SunDevilRocketry/Flight-Computer/README.md

<h1>Flight Computer</h1>

<p><b>Current PCB Revision:</b> 2.0</p>
<p><b>PCB Part Number:</b> A0002</p>

<p>The Avionics team aims to produce a general purpose flight computer 
 for use in high powered rocketry projects that require an embedded processor
specialized for state estimation and control system implementation. The Avionics
flight computer PCB uses an ARM Microcontroller with embedded control and 
navigation sensors to provide a computationally capable embedded protoyping 
platform for high powered rocketry projects with minimal wiring and a small
 form factor.</p>

<b>Working Directory Structure:</b>
 
 <p>
doc: documentation
    
src: source design files, e.g. schematic and board files
 
lib: libraries for schematic symbols and footprints
 
production: files needed for pcb fabrication, e.g. gerbers, profile, drill fi    le
 
 sim: simulation files 
  
 cad: 3d models
   
 img: images of circuit/footprints for github display 
 </p>

<h2>3D Model: </h2>

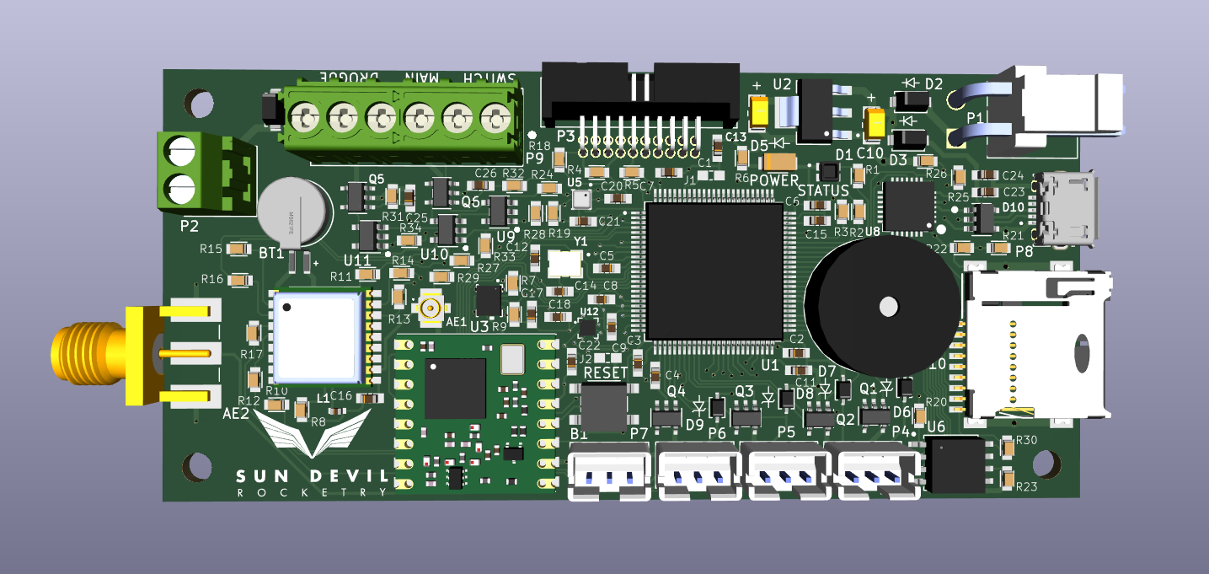
[picture p1: img/Flight-Computer-TOP.png]

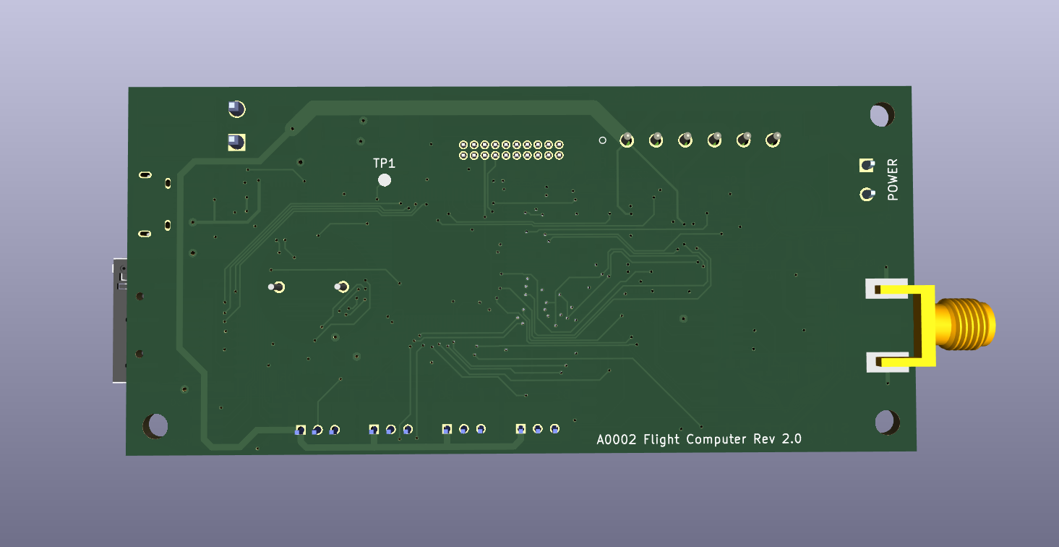
[picture p2: img/Flight-Computer-BOTTOM.png]
