SunDevilRocketry/Flight-Computer/CAD/README.md

<h1>CAD</h1>

Folder for all PCB 3D Models (STEP)

Use the folder "3Dfiles" for individual components' STEP files
