SunDevilRocketry/Flight-Computer/doc/README.md

<h1>Documentation</h1>

Folder for all PCB documentation
