SunDevilRocketry/Flight-Computer/img/README.md

<h1>Images</h1>

Folder for all PCB images to be displayed on GitHub

To show a picture, use the following html syntax: 
