SunDevilRocketry/Flight-Computer/src/README.md

<h1>Source Design Files</h1>

Folder for all PCB design files, including project, schematic, and PCB layout 
files
