SunDevilRocketry/Flight-Computer/CAD/3Dfiles/README.md

Folder for all PCB component step files

Download the files from online and keep them all here
