SunDevilRocketry/Flight-Computer/CAD/3Dfiles/BMI323.step

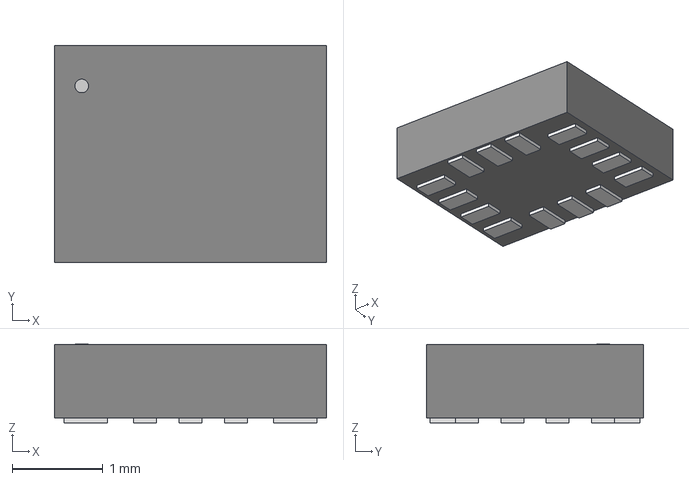
[picture p3: CAD file, 2022-12-14]
CAD/3Dfiles/BMI323.step
3.00 x 2.39 x 0.866 mm
