SunDevilRocketry/Flight-Computer/CAD/3Dfiles/BMM150.step

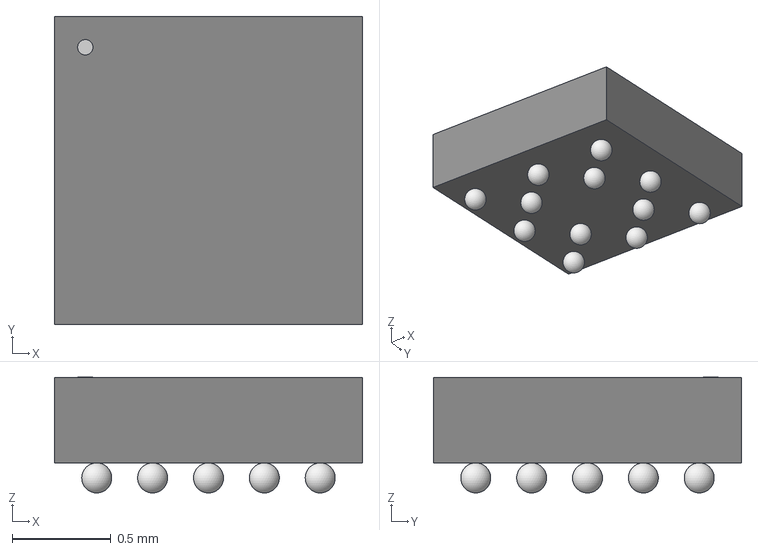
[picture p4: CAD file, 2022-12-14]
CAD/3Dfiles/BMM150.step
1.56 x 1.56 x 0.587 mm
