SunDevilRocketry/Flight-Computer/CAD/3Dfiles/AT-1438-TWT-R.STEP

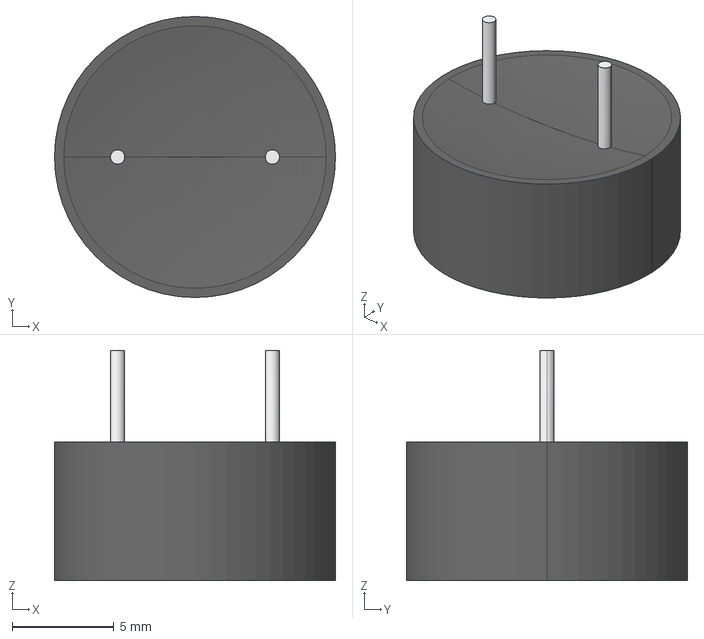
[picture p5: CAD file, 2022-06-05]
CAD/3Dfiles/AT-1438-TWT-R.STEP
13.8 x 13.8 x 11.3 mm
