SunDevilRocketry/Flight-Computer/CAD/3Dfiles/MEM2075-00-140-01-A.stp

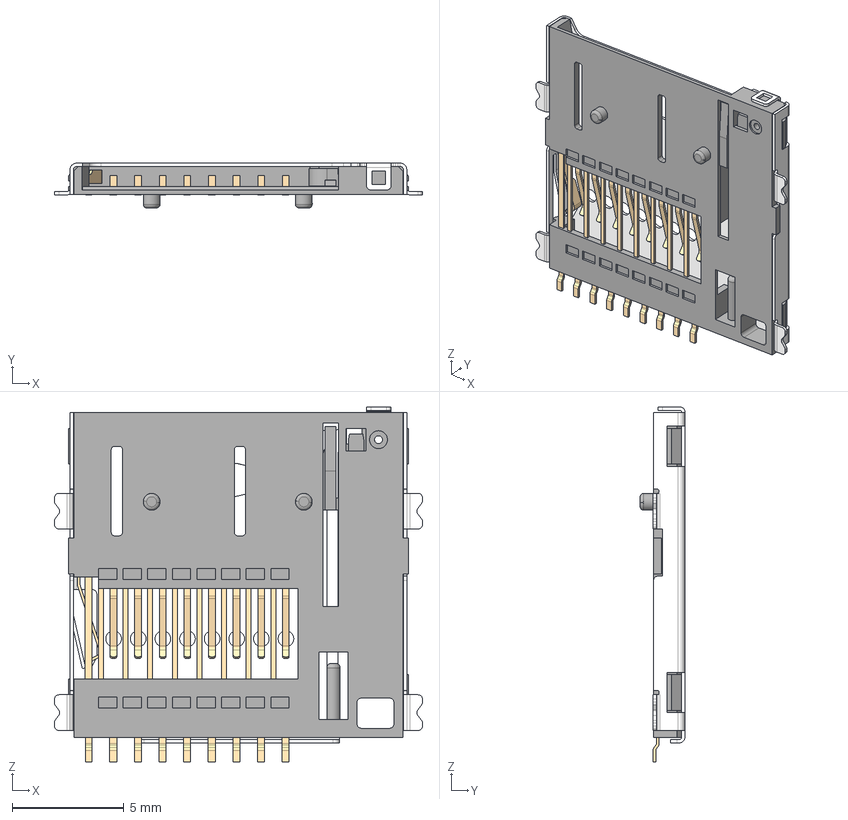
[picture p6: CAD file, 2022-06-04]
CAD/3Dfiles/MEM2075-00-140-01-A.stp
16.4 x 2.00 x 15.9 mm
Ëõ·Å±ÈÀý1
Í¹Ì¨-ÀÉì1
Á¬½ÓÖØ×é1
