SunDevilRocketry/Flight-Computer/CAD/3Dfiles/L-07C27NJV6T.step

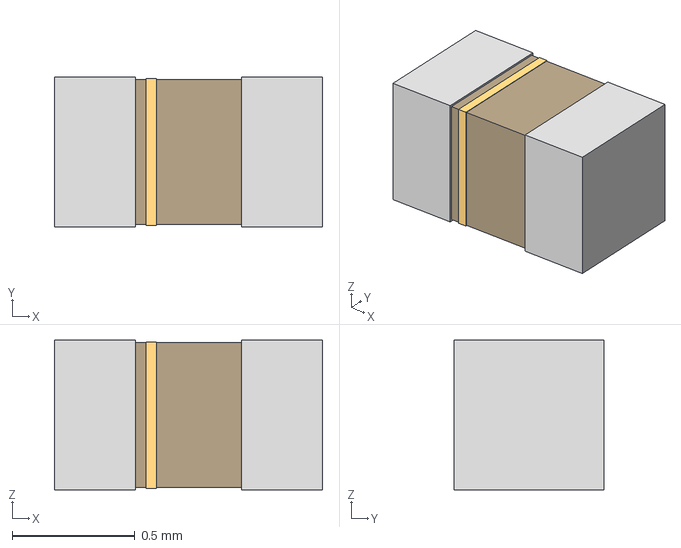
[picture p7: CAD file, 2022-06-01]
CAD/3Dfiles/L-07C27NJV6T.step
1.09 x 0.61 x 0.61 mm
