SunDevilRocketry/Flight-Computer/CAD/3Dfiles/MM3Z3V3B.step

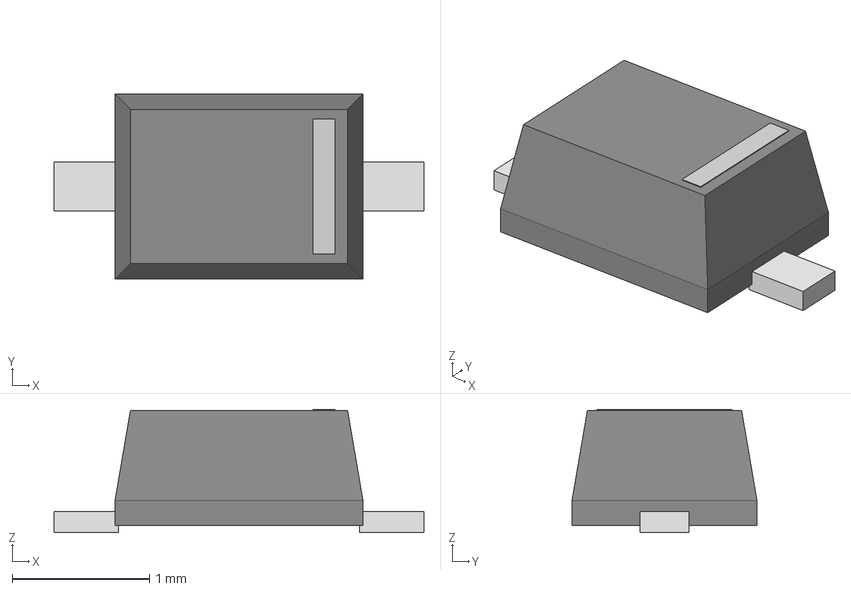
[picture p8: CAD file, 2022-06-01]
CAD/3Dfiles/MM3Z3V3B.step
2.69 x 1.35 x 0.895 mm
