SunDevilRocketry/Flight-Computer/CAD/3Dfiles/MS621FE-1.STEP

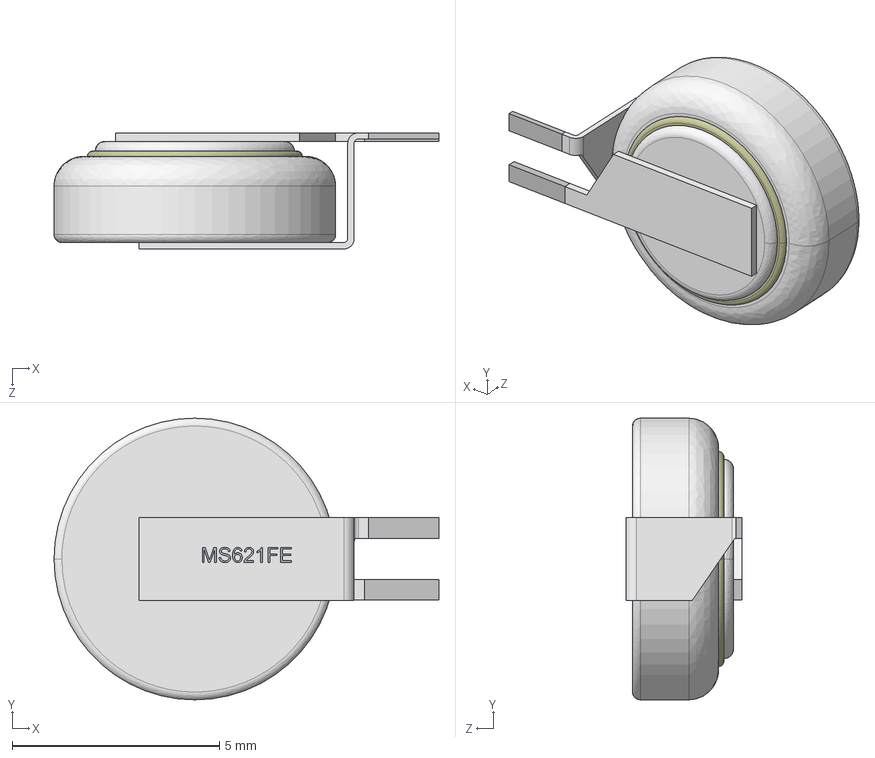
[picture p10: CAD file, 2022-05-29]
CAD/3Dfiles/MS621FE-1.STEP
9.29 x 6.80 x 2.80 mm
