SunDevilRocketry/Flight-Computer/CAD/3Dfiles/MAX-8C-0-10.step

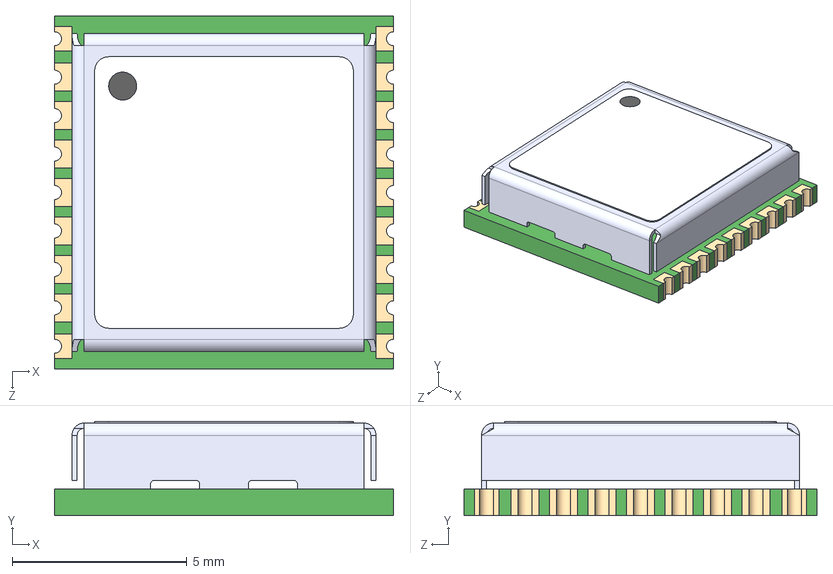
[picture p12: CAD file, 2022-05-28]
CAD/3Dfiles/MAX-8C-0-10.step
9.70 x 2.70 x 10.1 mm
