SunDevilRocketry/Flight-Computer/CAD/3Dfiles/MPU-9250.step

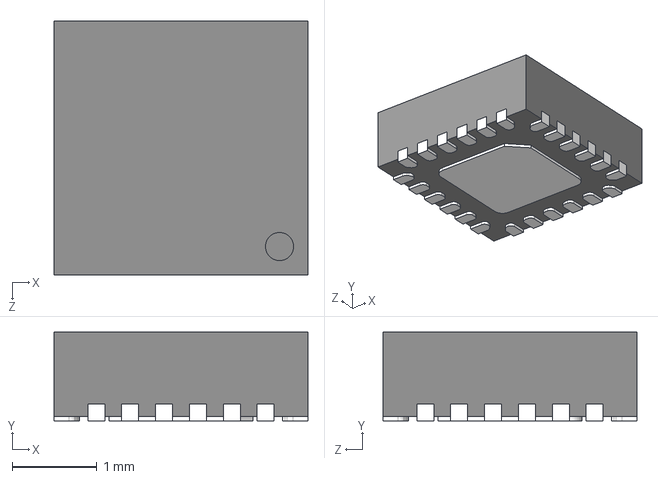
[picture p13: CAD file, 2022-05-23]
CAD/3Dfiles/MPU-9250.step
3.00 x 1.05 x 3.00 mm
