SunDevilRocketry/Flight-Computer/CAD/3Dfiles/TS391lYLT.step

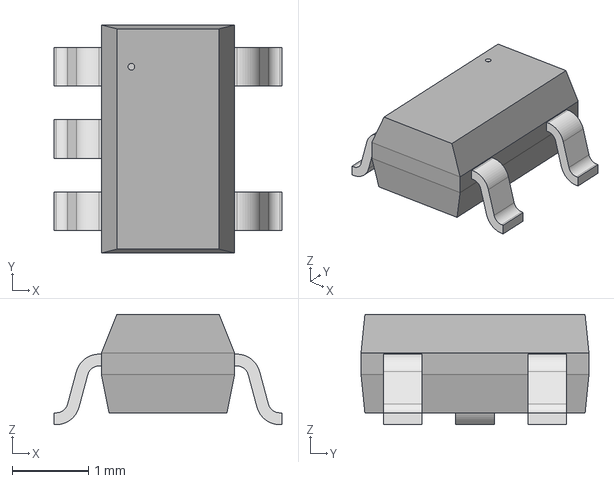
[picture p14: CAD file, 2022-05-23]
CAD/3Dfiles/TS391lYLT.step
3.00 x 3.00 x 1.45 mm
