SunDevilRocketry/Flight-Computer/CAD/3Dfiles/CP2102-GMR_QFN28.step

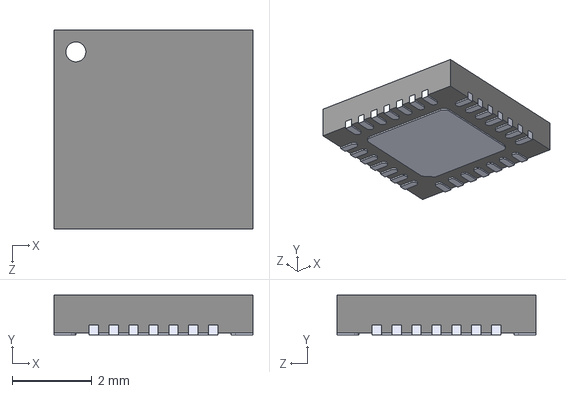
[picture p15: CAD file, 2022-05-22]
CAD/3Dfiles/CP2102-GMR_QFN28.step
5.00 x 1.00 x 5.00 mm
