SunDevilRocketry/Flight-Computer/CAD/3Dfiles/SM5819PL-TP.step

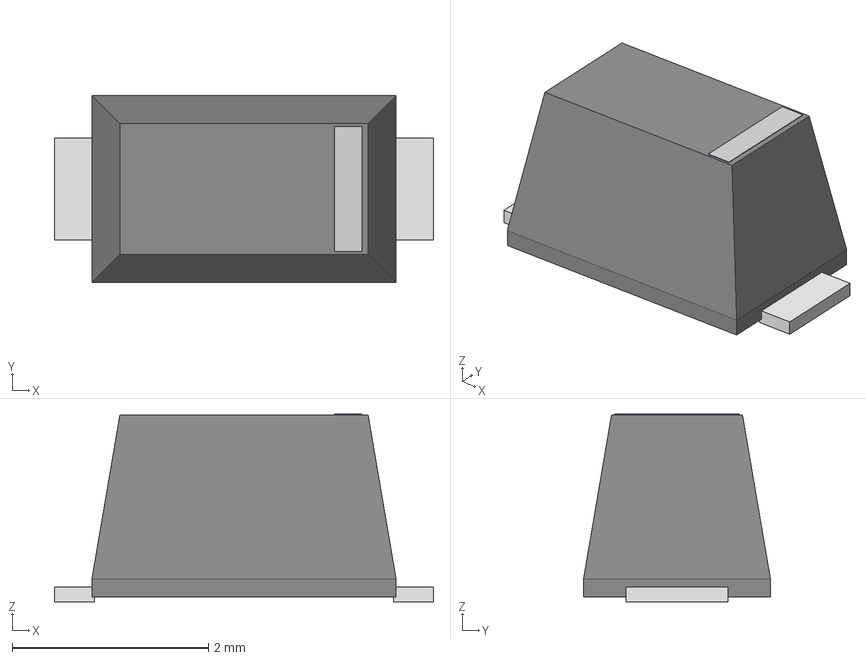
[picture p16: CAD file, 2022-05-22]
CAD/3Dfiles/SM5819PL-TP.step
3.86 x 1.90 x 1.91 mm
