SunDevilRocketry/Flight-Computer/CAD/3Dfiles/ECS-240-18-33-JGN-TR.STEP

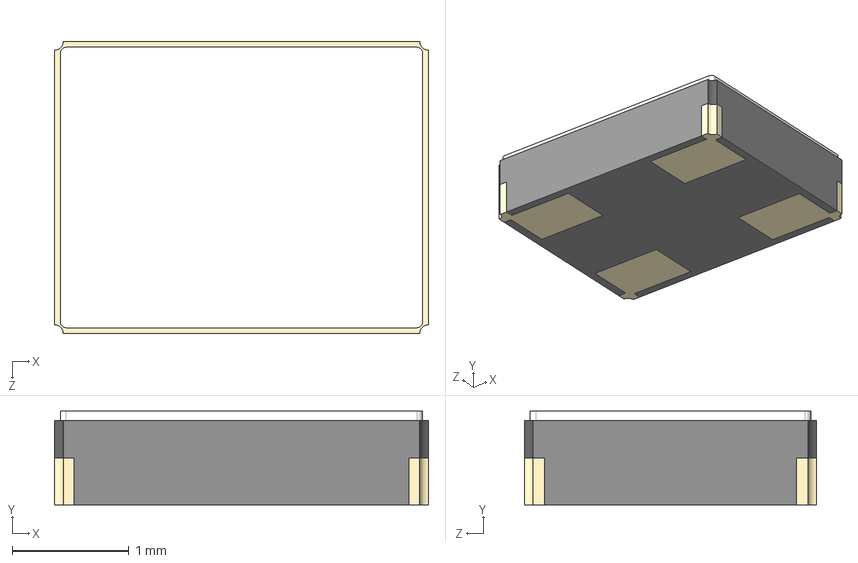
[picture p17: CAD file, 2022-05-22]
CAD/3Dfiles/ECS-240-18-33-JGN-TR.STEP
3.20 x 0.8 x 2.50 mm
