SunDevilRocketry/Flight-Computer/CAD/3Dfiles/CLMVC-FKA-CL1D1L71BB7C3C3.STEP

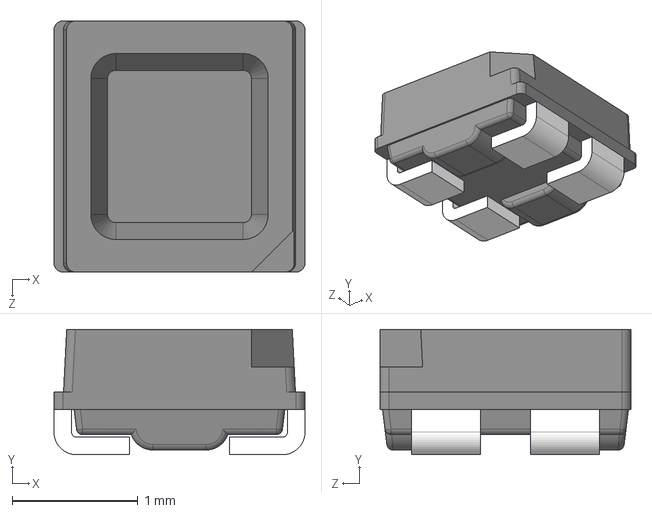
[picture p18: CAD file, 2022-05-22]
CAD/3Dfiles/CLMVC-FKA-CL1D1L71BB7C3C3.STEP
2.00 x 1 x 2.00 mm
