SunDevilRocketry/Flight-Computer/CAD/3Dfiles/SP0504BAHTG.step

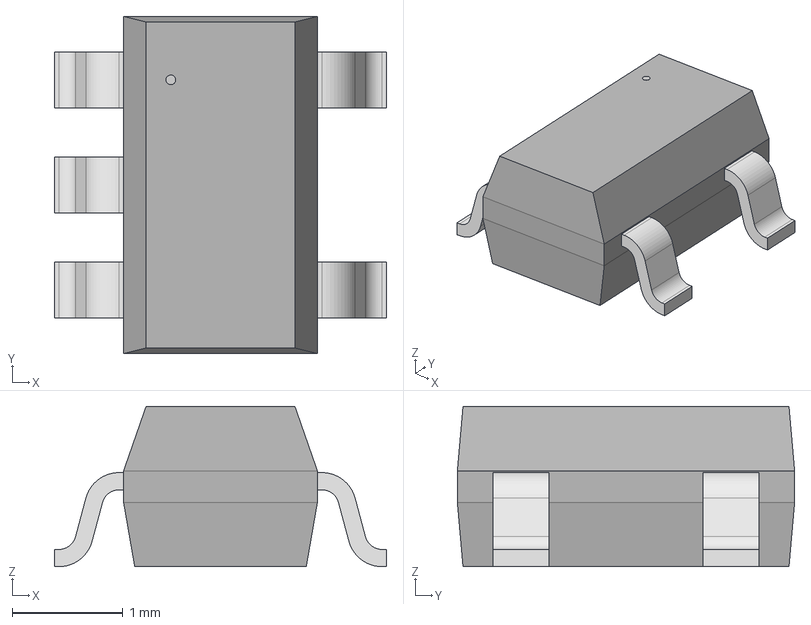
[picture p19: CAD file, 2022-05-22]
CAD/3Dfiles/SP0504BAHTG.step
3.00 x 3.05 x 1.45 mm
