SunDevilRocketry/Flight-Computer/CAD/3Dfiles/3220-20-0200-00.stp

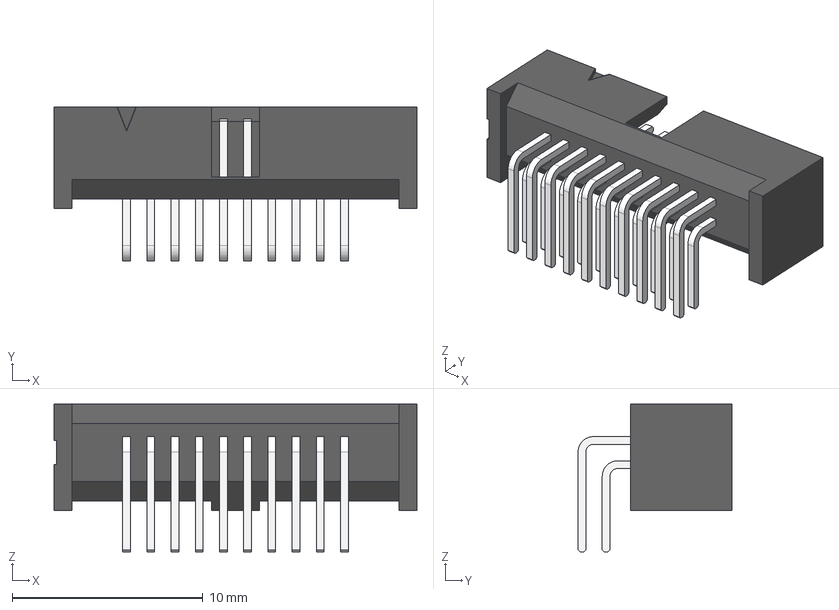
[picture p20: CAD file, 2022-05-22]
CAD/3Dfiles/3220-20-0200-00.stp
19.1 x 8.08 x 7.75 mm
_SHF-110-01-D_header
_SHF-First_Position_Indicator
_T-1S71-02-10-D-RA
