SunDevilRocketry/Flight-Computer/CAD/3Dfiles/QS5U17TR.step

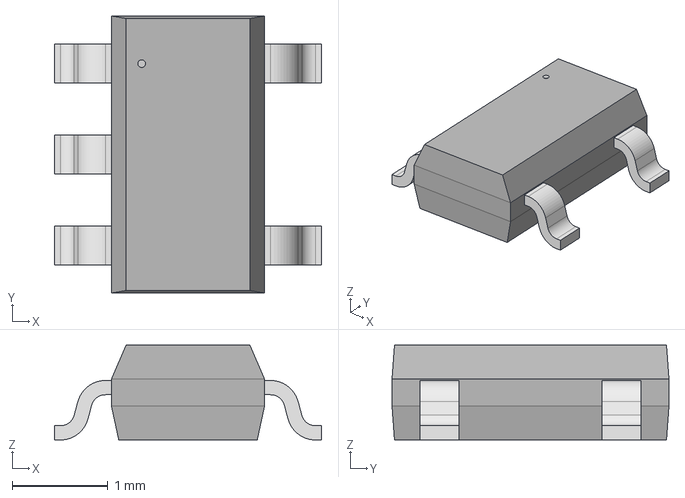
[picture p21: CAD file, 2022-05-22]
CAD/3Dfiles/QS5U17TR.step
2.79 x 2.90 x 0.993 mm
