SunDevilRocketry/Flight-Computer/CAD/3Dfiles/T491A106K010AT.step

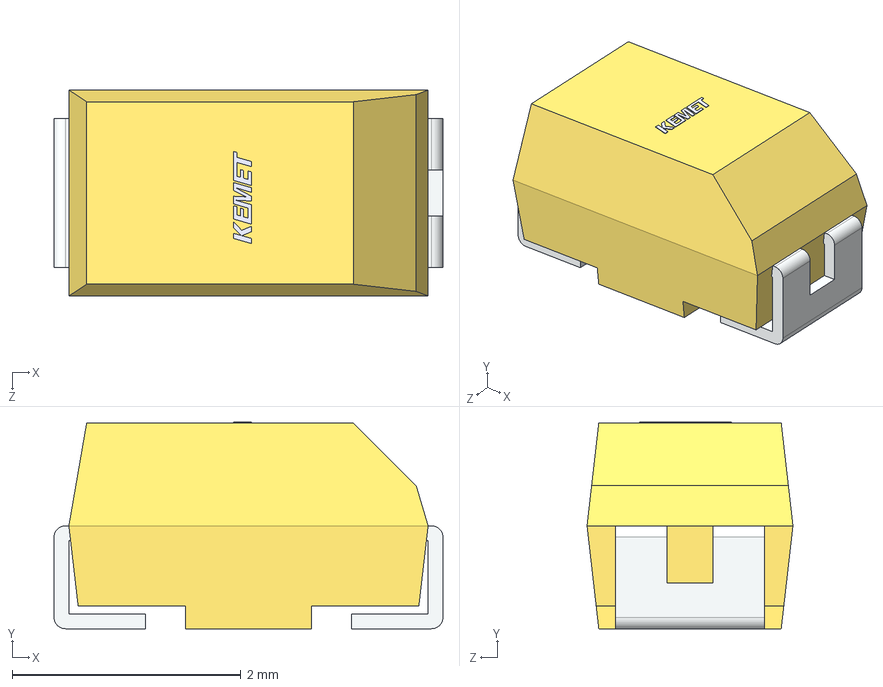
[picture p22: CAD file, 2022-05-22]
CAD/3Dfiles/T491A106K010AT.step
3.40 x 1.81 x 1.80 mm
