SunDevilRocketry/Flight-Computer/CAD/3Dfiles/SML-LX1206GC-TR.step

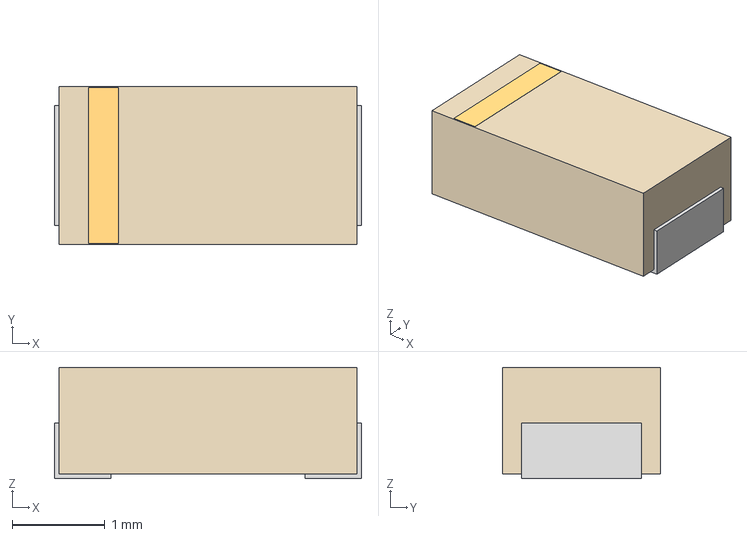
[picture p23: CAD file, 2022-05-22]
CAD/3Dfiles/SML-LX1206GC-TR.step
3.30 x 1.70 x 1.20 mm
