SunDevilRocketry/Flight-Computer/CAD/3Dfiles/PTS647SM38SMTR2LFS.step

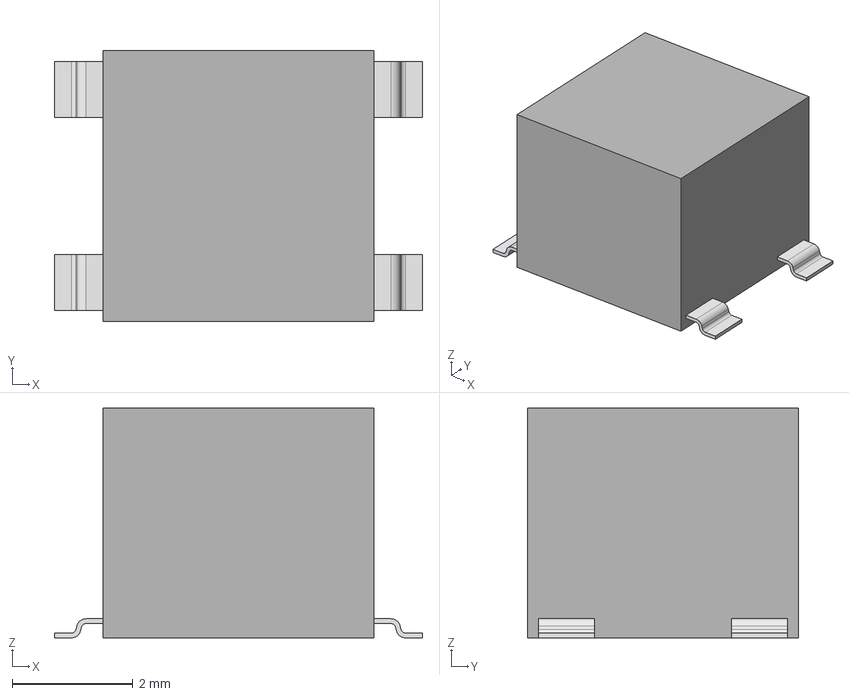
[picture p24: CAD file, 2022-05-22]
CAD/3Dfiles/PTS647SM38SMTR2LFS.step
6.10 x 4.50 x 3.81 mm
