SunDevilRocketry/Flight-Computer/CAD/3Dfiles/TPS2115APWR.step

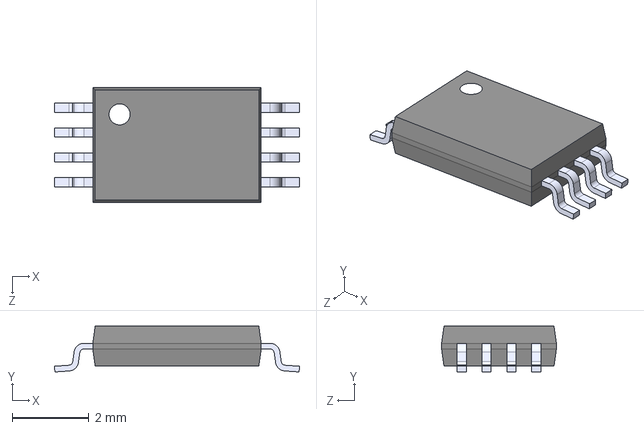
[picture p25: CAD file, 2022-05-22]
CAD/3Dfiles/TPS2115APWR.step
6.40 x 1.20 x 3.00 mm
