SunDevilRocketry/Flight-Computer/CAD/3Dfiles/SST25VF040B-50-4I-S2AE-T.step

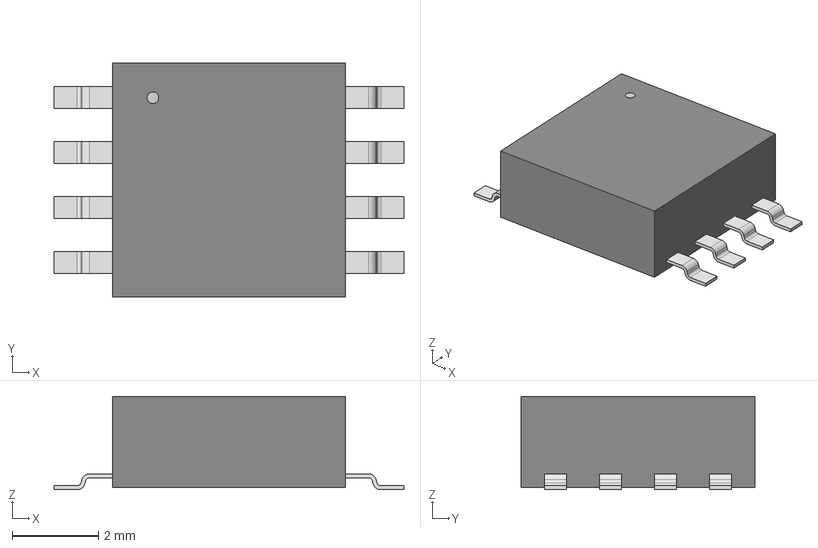
[picture p26: CAD file, 2022-05-22]
CAD/3Dfiles/SST25VF040B-50-4I-S2AE-T.step
8.10 x 5.41 x 2.16 mm
