SunDevilRocketry/Flight-Computer/CAD/3Dfiles/LMS8117AMP-3.3_NOPB.step

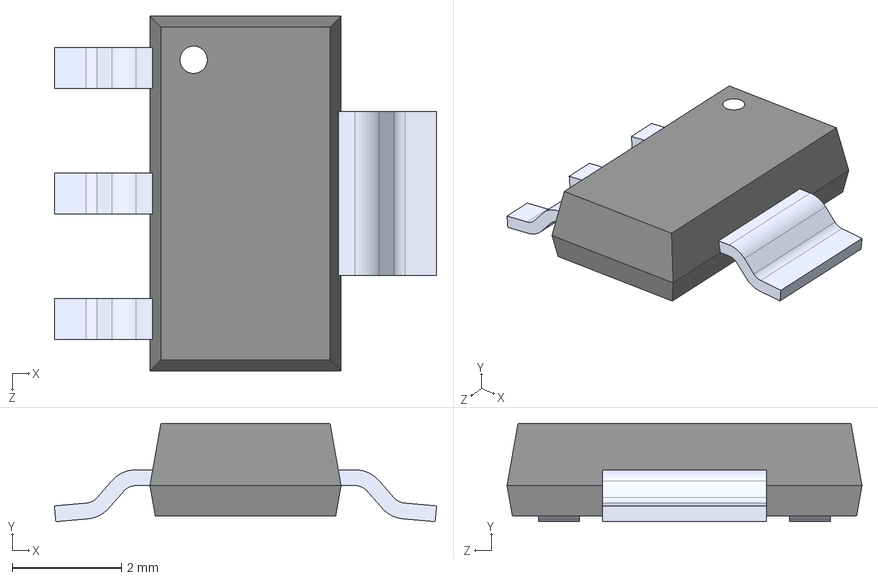
[picture p27: CAD file, 2021-07-20]
CAD/3Dfiles/LMS8117AMP-3.3_NOPB.step
7.00 x 1.80 x 6.50 mm
