SunDevilRocketry/Flight-Computer/CAD/3Dfiles/SBH11-PBPC-D05-RA-BK.stp

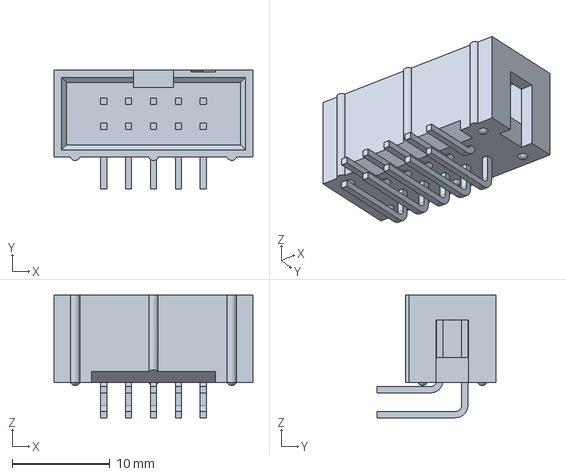
[picture p28: CAD file, 2021-07-20]
CAD/3Dfiles/SBH11-PBPC-D05-RA-BK.stp
20.3 x 12.1 x 12.5 mm
