SunDevilRocketry/Flight-Computer/CAD/3Dfiles/RES_0603.step

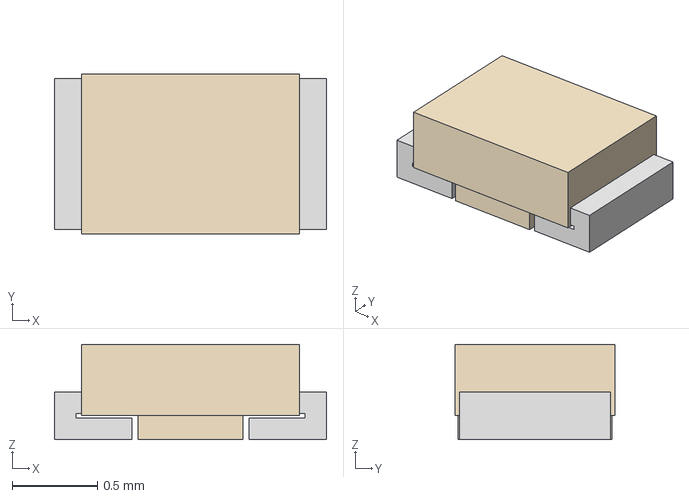
[picture p29: CAD file, 2021-07-20]
CAD/3Dfiles/RES_0603.step
1.60 x 0.94 x 0.559 mm
