SunDevilRocketry/Flight-Computer/CAD/3Dfiles/CAP_0603.step

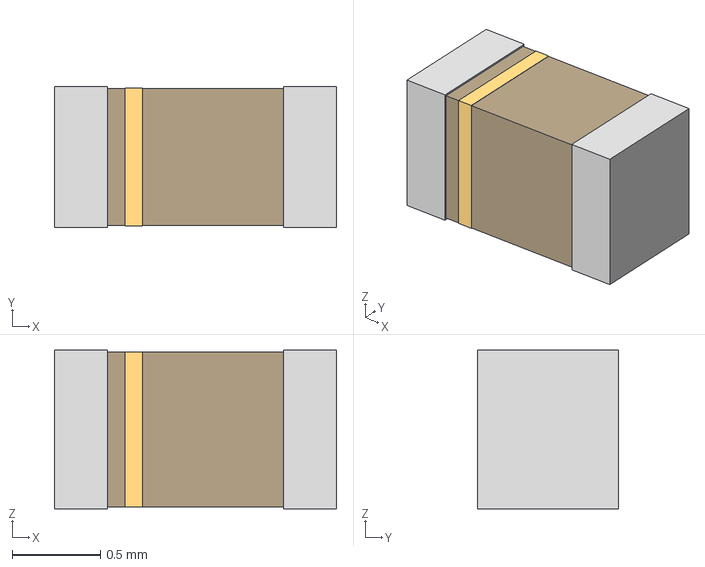
[picture p30: CAD file, 2021-07-20]
CAD/3Dfiles/CAP_0603.step
1.60 x 0.8 x 0.9 mm
