SunDevilRocketry/Flight-Computer/CAD/3Dfiles/RES_0805.step

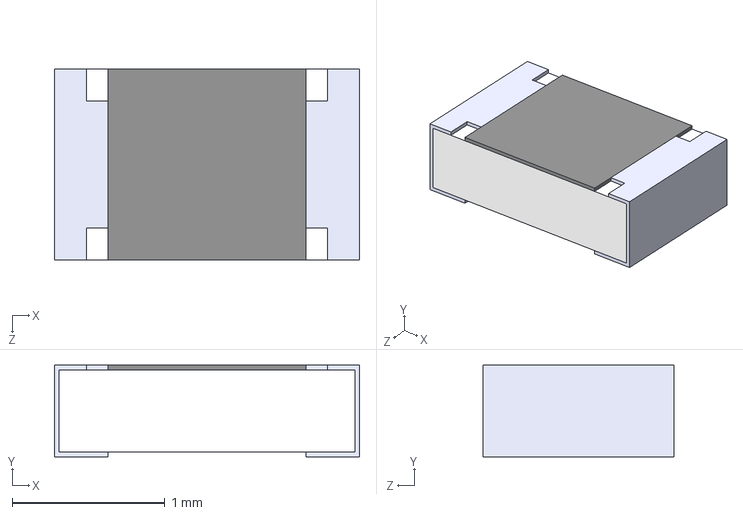
[picture p31: CAD file, 2021-07-20]
CAD/3Dfiles/RES_0805.step
2.00 x 0.6 x 1.25 mm
