SunDevilRocketry/Flight-Computer/CAD/3Dfiles/stm32h750vbt6.stp

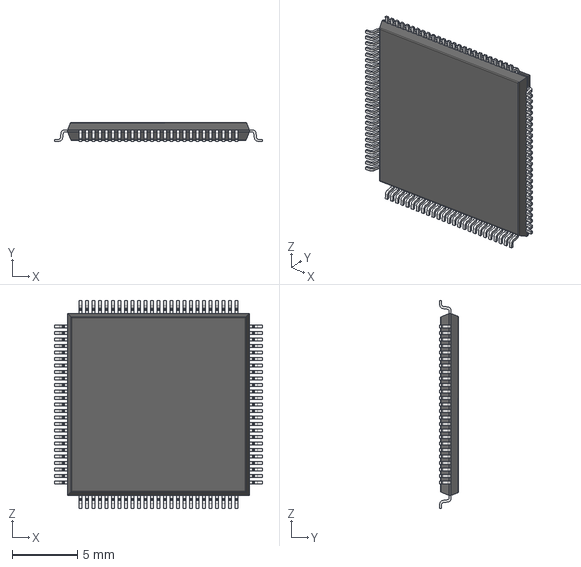
[picture p32: CAD file, 2021-07-14]
CAD/3Dfiles/stm32h750vbt6.stp
16.0 x 1.48 x 16.0 mm
