SunDevilRocketry/Flight-Computer/(list of files, cad)

Other CAD files:
CAD/3Dfiles/10118194-0001LF.step
CAD/3Dfiles/1546551-2.step
CAD/3Dfiles/1984659.stp
CAD/3Dfiles/282837-2.step
CAD/3Dfiles/282837-6.STEP
CAD/3Dfiles/440054-3.step
CAD/3Dfiles/440129-3.stp
CAD/3Dfiles/647676-2.step
CAD/3Dfiles/73412-0110.step
