SunDevilRocketry/Flight-Computer/(threads)

Thread 1 (2025-01-24):

Update BOM list

niekky, 2025-01-24:
Revisit Flight Computer Rev 2 materials list: https://docs.google.com/spreadsheets/d/1Ugaq-XcAd0ocDZOmZ5_AGwxQUCF7xJ_5cvLZlJQq34M/edit?gid=0#gid=0

Do the followings:
- Highlight red any components (IC chips, resistors, capacitors, inductors) that are either out of stock or no longer in manufacture in Digikey
- Make a sublist/subsheet to find good alternatives to out of stock components.

niekky, 2025-01-24:
@266-750Balloons Hey Drew, you can help us look for good alternatives for RFM95 here in this issue.

niekky, 2025-02-03:
Drew's quote in Jan 31 meeting: "MAX-F10s: https://www.digikey.com/en/products/detail/u-blox/MAX-F10S-00B/24708222?s=N4IgTCBcDaILIEEAaBaAYgRgAwGUQF0BfIA

It's pin-compatible with the MAX8 that we used in REV2.
There might be other parts that are much smaller."

Closed 2025-01-28.

Thread 2 (2025-01-24):

Design schematic and a quick pcb for BMM350

niekky, 2025-01-24:
Regarding the fact that BMI150 is no longer available, BMI350 is the same manufacturer magnetometer alternative.

Design a schematic that only contains basic STM32H7 (the same chip on rev2) with the same electrical rev2 configuration and BMI350. This design would help visualize the layout of BMI350 on the flight computer rev2

Please branch out of Flight-Computer repository and attach screenshots of both schematic and the pcb layout for review and approval.

dmortloff, 2025-01-28:
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
Schematic and PCB designs for BMM 350 Magnetometer
Worth noting that VDD requires 1.8 Volt input, which current flight computer lacks
Branched out of Flight Computer in branch BMM350, in Flight-Computer/src/BMM350

dmortloff, 2025-01-31:
2 1k ohm resistors used for voltage divider from 3.3 to 1.8 V for BMM 350
BMM 350 max limits: 3.5 mA
BMM 350 nominal limits: 200 uA

dmortloff, 2025-01-31:
Secondary Issues: the component is way too big.
IC requires 3 capacitors, and voltage divider requires 2 resistors
BMM150 is 2x2mm, BMM350 is way bigger

dmortloff, 2025-02-05:
Added voltage divider from 3.3-1.8, and added schematic and PCB design for said component and connection to BMM350

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

dmortloff, 2025-02-08:
Finished BMM350 Schematic with new S85S1A converter along with basic PCB routing

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
https://www.digikey.com/en/products/detail/ablic-inc/S-85S1AB18-I6T1U/9489538

Closed 2025-02-14.

Thread 3 (2025-02-03):

Expand pcb area for BMM350

niekky, 2025-02-03:
We are replacing BMM150 with BMM350 since BMM150 is no longer in manufacture but BMM350 is bigger and requires more passive components along.

dmortloff, 2025-02-08:
Various components resized, as well as added components for linear regulator. All fits within standard board BMM150 allocated space.

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

Closed 2025-02-14.
