SunDevilRocketry/Flight-Computer/doc/Flight-Computer.pdf

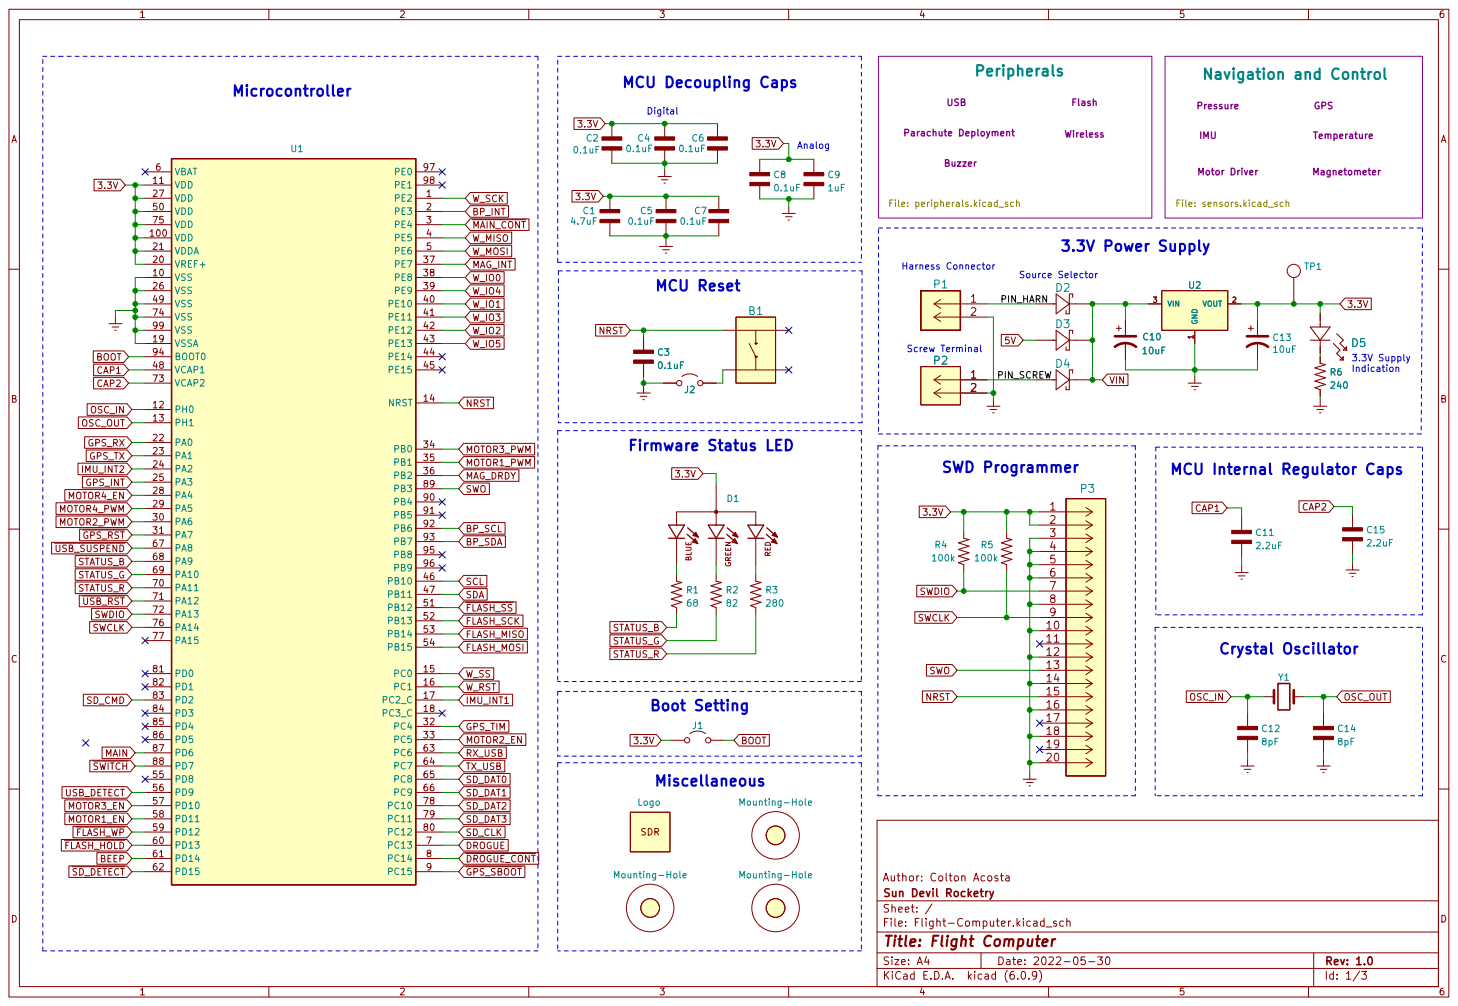
[picture p33: page 1]

Navigation and Control File: sensors.kicad_sch

SWCLK NRST NRST SCL TX_USB

SWD Programmer

MCU Internal Regulator Caps

File: Flight-Computer.kicad_sch Sheet: / Sun Devil Rocketry Author: Colton Acosta

Id: 1/3 Title: Flight Computer

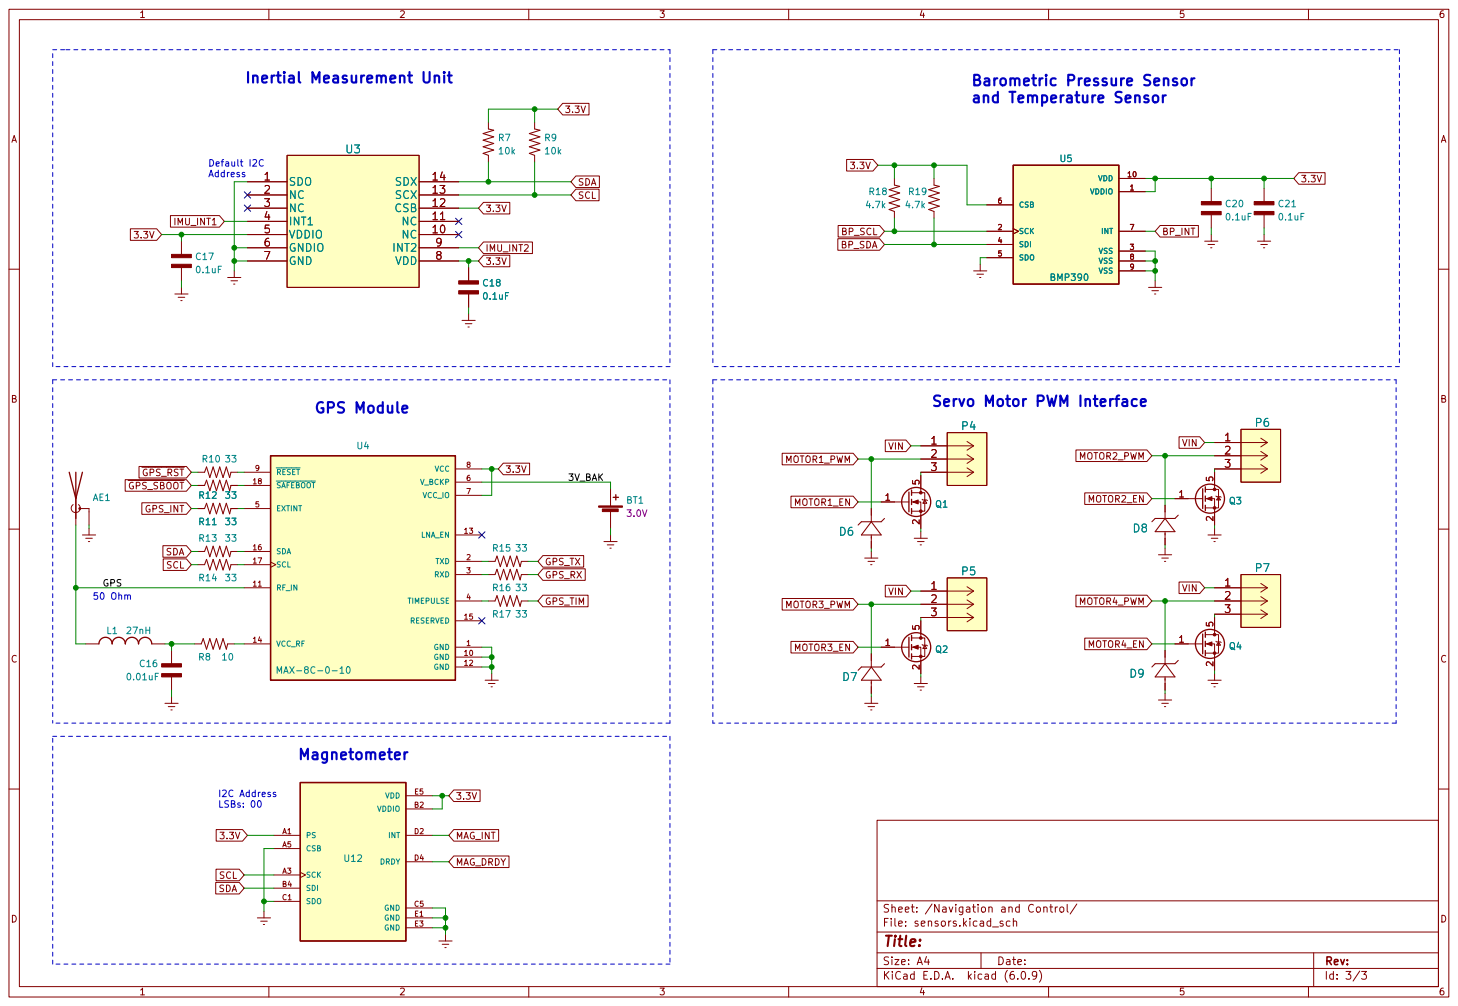
[picture p34: page 2]

Inertial Measurement Unit Default I2C Address 50 Ohm

Sheet: /Navigation and Control/
File: sensors.kicad_sch
Id: 3/3 Title:

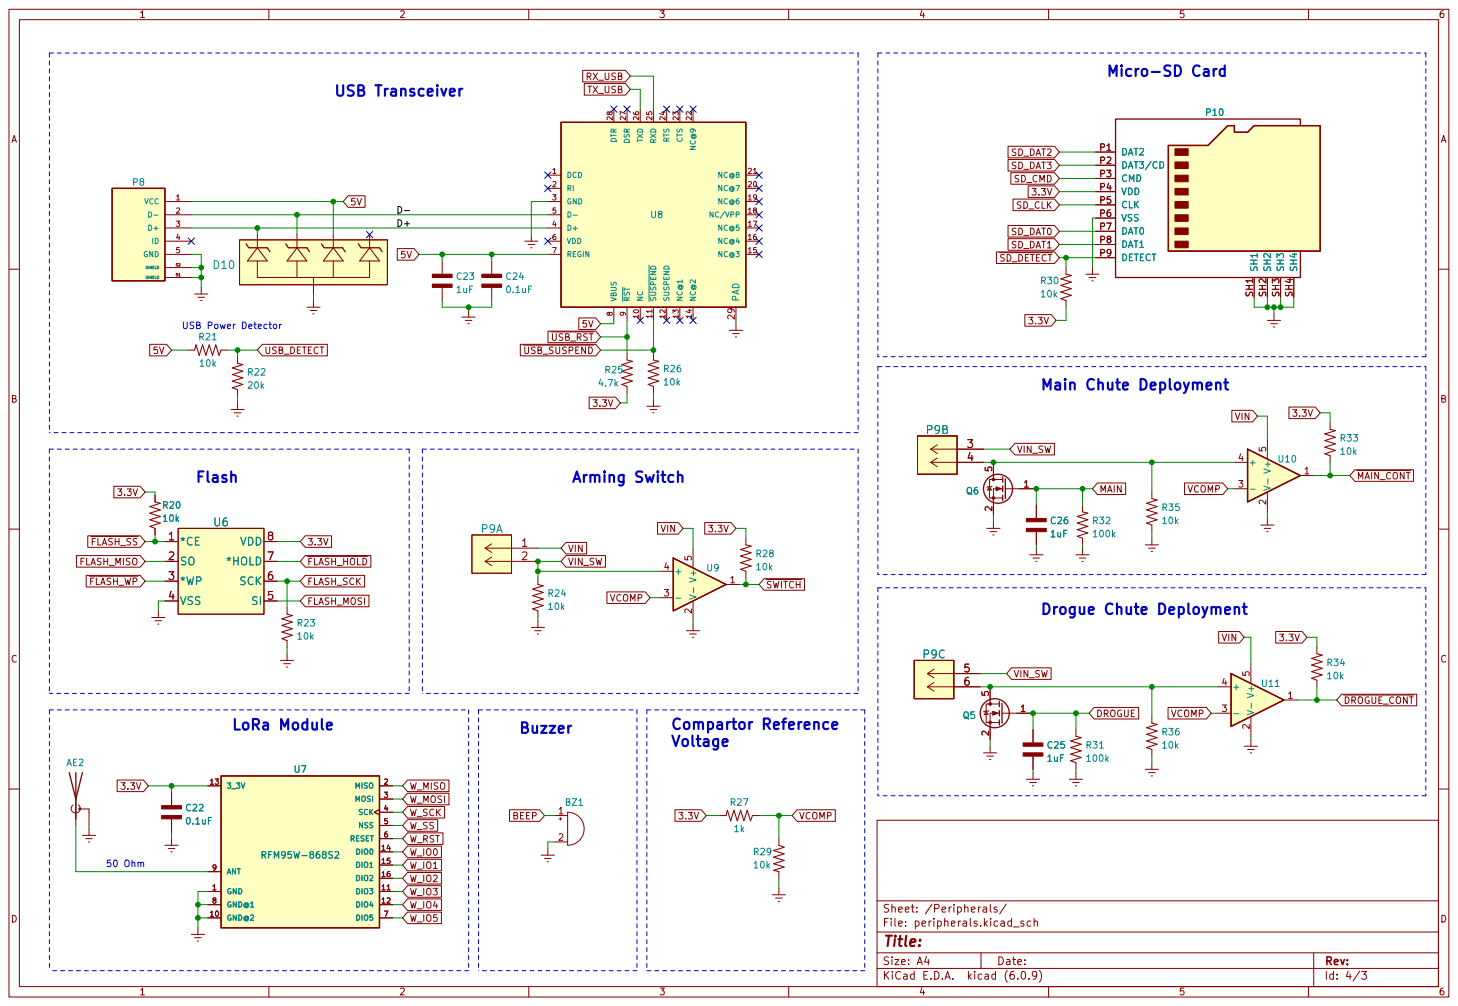
[picture p35: page 3]
