SunDevilRocketry/Flight-Computer/src/Flight-Computer/Flight-Computer.kicad_pcb

## KiCad design src/Flight-Computer/Flight-Computer.kicad_pcb (2023-01-07)

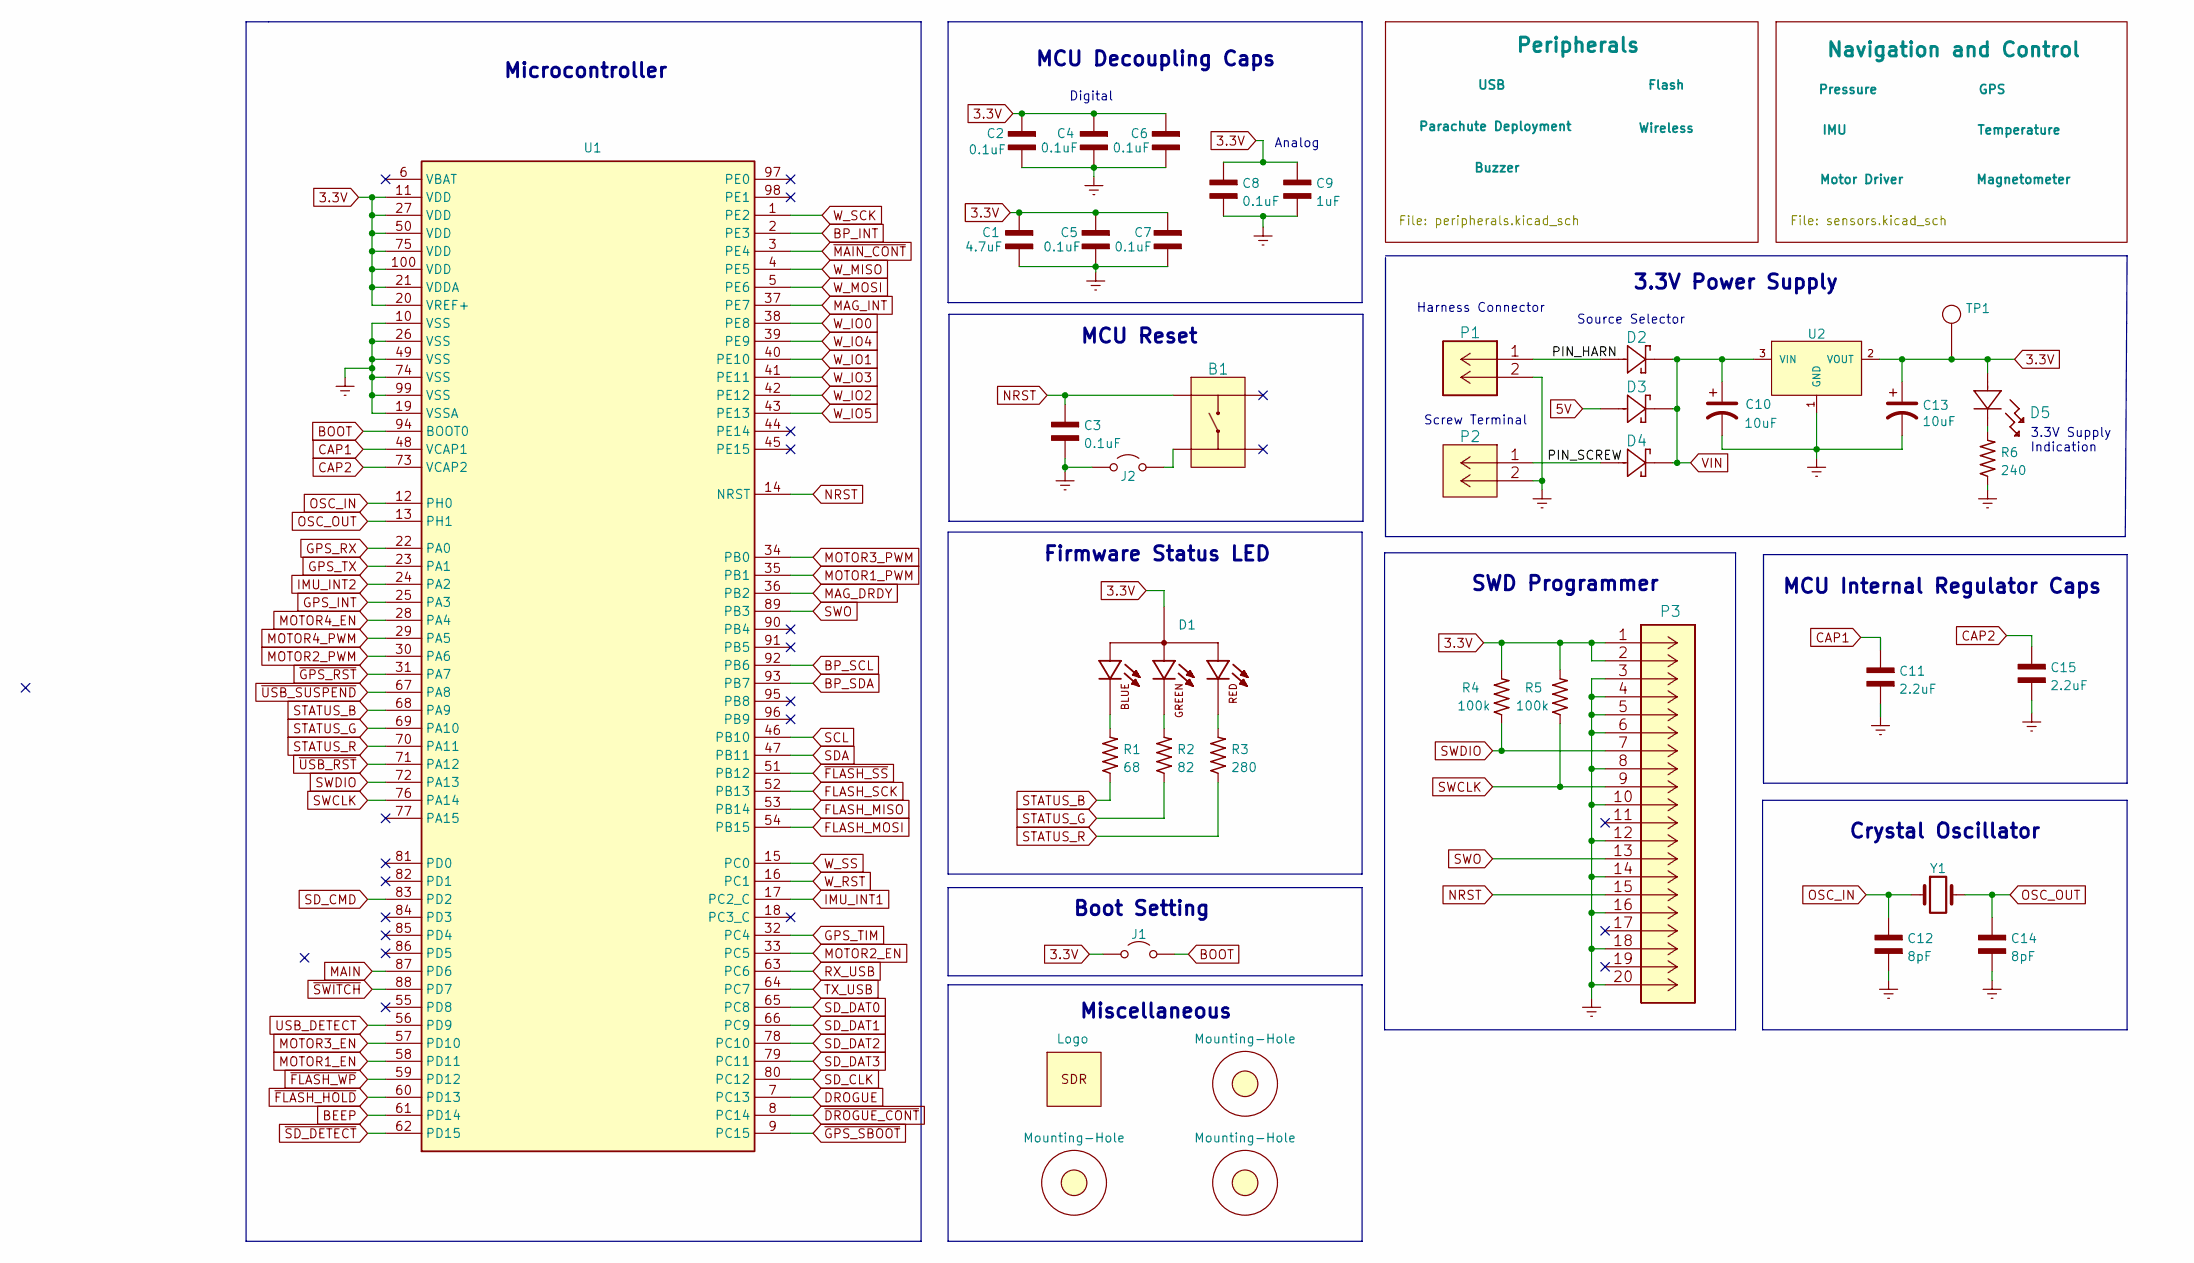
[picture p36: schematic Flight-Computer.kicad_sch, Flight Computer]

Parts:
B1: PTS647SM38SMTR2LFS
C1: 4.7uF; CAP_0603
C2, C3, C4, C5, C6, C7, C8: 0.1uF; CAP_0603
C9: 1uF; CAP_0603
C10, C13: 10uF; T491A106K010AT
C11, C15: 2.2uF; CAP_0603
C12, C14: 8pF; CAP_0603
D1: CLMVC-FKA-CL1D1L71BB7C3C3
D2, D3, D4: SM5819PL-TP
D5: SML-LX1206GC-TR
H1, H2, H3: Mounting-Hole; MountingHole_3mm
J1, J2: Jumper_NO; Jumper-NO
LOGO1: Logo
P1: 647676-2
P2: 1546551-2
P3: 3220-20-0200-00
R1: 68; RES_0603
R2: 82; RES_0603
R3: 280; RES_0603
R4, R5: 100k; RES_0603
R6: 240; RES_0603
TP1: TP
U1: STM32H750VBTx; STM32H750VBT6
U2: LMS8117AMP-3.3_NOPB; LMS8117AMP-3.3NOPB
Y1: ECS-240-18-33-JGN-TR

Connections:
3.3V: C1.1, C2.1, C4.1, C5.1, C6.1, C7.1, C8.1, C9.1, C13.1, D1.1, D5.2, J1.1 (A), P3.1, P3.2, R4.2, R5.2, TP1.1, U1.11 (VDD), U1.20 (VREF+), U1.21 (VDDA), U1.27 (VDD), U1.50 (VDD), U1.75 (VDD), U1.100 (VDD), U2.2 (VOUT); also elsewhere on the board
5V: D3.2; also elsewhere on the board
/PIN_HARN: D2.2, P1.1
/PIN_SCREW: D4.2, P2.1 (5)
BEEP: U1.61 (PD14); also elsewhere on the board
BOOT: J1.2 (B), U1.94 (BOOT0)
BP_INT: U1.2 (PE3); also elsewhere on the board
BP_SCL: U1.92 (PB6); also elsewhere on the board
BP_SDA: U1.93 (PB7); also elsewhere on the board
CAP1: C11.1, U1.48 (VCAP1)
CAP2: C15.1, U1.73 (VCAP2)
DROGUE: U1.7 (PC13); also elsewhere on the board
Earth: C1.2, C2.2, C3.2, C4.2, C5.2, C6.2, C7.2, C8.2, C9.2, C10.2, C11.2, C12.2, C13.2, C14.2, C15.2, J2.1 (A), P1.2, P2.2 (6), P3.3, P3.4, P3.5, P3.6, P3.8, P3.10, P3.12, P3.14, P3.16, P3.18, P3.20, R6.1, U1.10 (VSS), U1.19 (VSSA), U1.26 (VSS), U1.49 (VSS), U1.74 (VSS), U1.99 (VSS), U2.1 (GND); also elsewhere on the board
FLASH_MISO: U1.53 (PB14); also elsewhere on the board
FLASH_MOSI: U1.54 (PB15); also elsewhere on the board
FLASH_SCK: U1.52 (PB13); also elsewhere on the board
GPS_INT: U1.25 (PA3); also elsewhere on the board
GPS_RX: U1.22 (PA0); also elsewhere on the board
GPS_TIM: U1.32 (PC4); also elsewhere on the board
GPS_TX: U1.23 (PA1); also elsewhere on the board
IMU_INT1: U1.17 (PC2_C); also elsewhere on the board
IMU_INT2: U1.24 (PA2); also elsewhere on the board
MAG_DRDY: U1.36 (PB2); also elsewhere on the board
MAG_INT: U1.37 (PE7); also elsewhere on the board
MAIN: U1.87 (PD6); also elsewhere on the board
MOTOR1_EN: U1.58 (PD11); also elsewhere on the board
MOTOR1_PWM: U1.35 (PB1); also elsewhere on the board
MOTOR2_EN: U1.33 (PC5); also elsewhere on the board
MOTOR2_PWM: U1.30 (PA6); also elsewhere on the board
MOTOR3_EN: U1.57 (PD10); also elsewhere on the board
MOTOR3_PWM: U1.34 (PB0); also elsewhere on the board
MOTOR4_EN: U1.28 (PA4); also elsewhere on the board
MOTOR4_PWM: U1.29 (PA5); also elsewhere on the board
NRST: B1.3, C3.1, P3.15, U1.14 (NRST)
unnamed: B1.1, J2.2 (B)
unnamed: D1.2, R1.2
unnamed: D1.3, R2.2
unnamed: D1.4, R3.2
unnamed: D5.1, R6.2
OSC_IN: C12.1, U1.12 (PH0), Y1.1
OSC_OUT: C14.1, U1.13 (PH1), Y1.3
RX_USB: U1.63 (PC6); also elsewhere on the board
SCL: U1.46 (PB10); also elsewhere on the board
SDA: U1.47 (PB11); also elsewhere on the board
SD_CLK: U1.80 (PC12); also elsewhere on the board
SD_CMD: U1.83 (PD2); also elsewhere on the board
SD_DAT0: U1.65 (PC8); also elsewhere on the board
SD_DAT1: U1.66 (PC9); also elsewhere on the board
SD_DAT2: U1.78 (PC10); also elsewhere on the board
SD_DAT3: U1.79 (PC11); also elsewhere on the board
STATUS_B: R1.1, U1.68 (PA9)
STATUS_G: R2.1, U1.69 (PA10)
STATUS_R: R3.1, U1.70 (PA11)
SWCLK: P3.9, R5.1, U1.76 (PA14)
SWDIO: P3.7, R4.1, U1.72 (PA13)
SWO: P3.13, U1.89 (PB3)
TX_USB: U1.64 (PC7); also elsewhere on the board
USB_DETECT: U1.56 (PD9); also elsewhere on the board
VIN: C10.1, D2.1, D3.1, D4.1, U2.3 (VIN); also elsewhere on the board
W_IO0: U1.38 (PE8); also elsewhere on the board
W_IO1: U1.40 (PE10); also elsewhere on the board
W_IO2: U1.42 (PE12); also elsewhere on the board
W_IO3: U1.41 (PE11); also elsewhere on the board
W_IO4: U1.39 (PE9); also elsewhere on the board
W_IO5: U1.43 (PE13); also elsewhere on the board
W_MISO: U1.4 (PE5); also elsewhere on the board
W_MOSI: U1.5 (PE6); also elsewhere on the board
W_RST: U1.16 (PC1); also elsewhere on the board
W_SCK: U1.1 (PE2); also elsewhere on the board
W_SS: U1.15 (PC0); also elsewhere on the board
~DROGUE_CONT: U1.8 (PC14); also elsewhere on the board
~FLASH_HOLD: U1.60 (PD13); also elsewhere on the board
~FLASH_SS: U1.51 (PB12); also elsewhere on the board
~FLASH_WP: U1.59 (PD12); also elsewhere on the board
~GPS_RST: U1.31 (PA7); also elsewhere on the board
~GPS_SBOOT: U1.9 (PC15); also elsewhere on the board
~MAIN_CONT: U1.3 (PE4); also elsewhere on the board
~SD_DETECT: U1.62 (PD15); also elsewhere on the board
~SWITCH: U1.88 (PD7); also elsewhere on the board
~USB_RST: U1.71 (PA12); also elsewhere on the board
~USB_SUSPEND: U1.67 (PA8); also elsewhere on the board

Notes on the sheet:
Crystal Oscillator
3.3V Power Supply
MCU Internal Regulator Caps
MCU Reset
Firmware Status LED
3.3V Supply Indication
Source Selector
MCU Decoupling Caps
Boot Setting
Miscellaneous
Analog
Screw Terminal
Microcontroller
Harness Connector
Digital
SWD Programmer

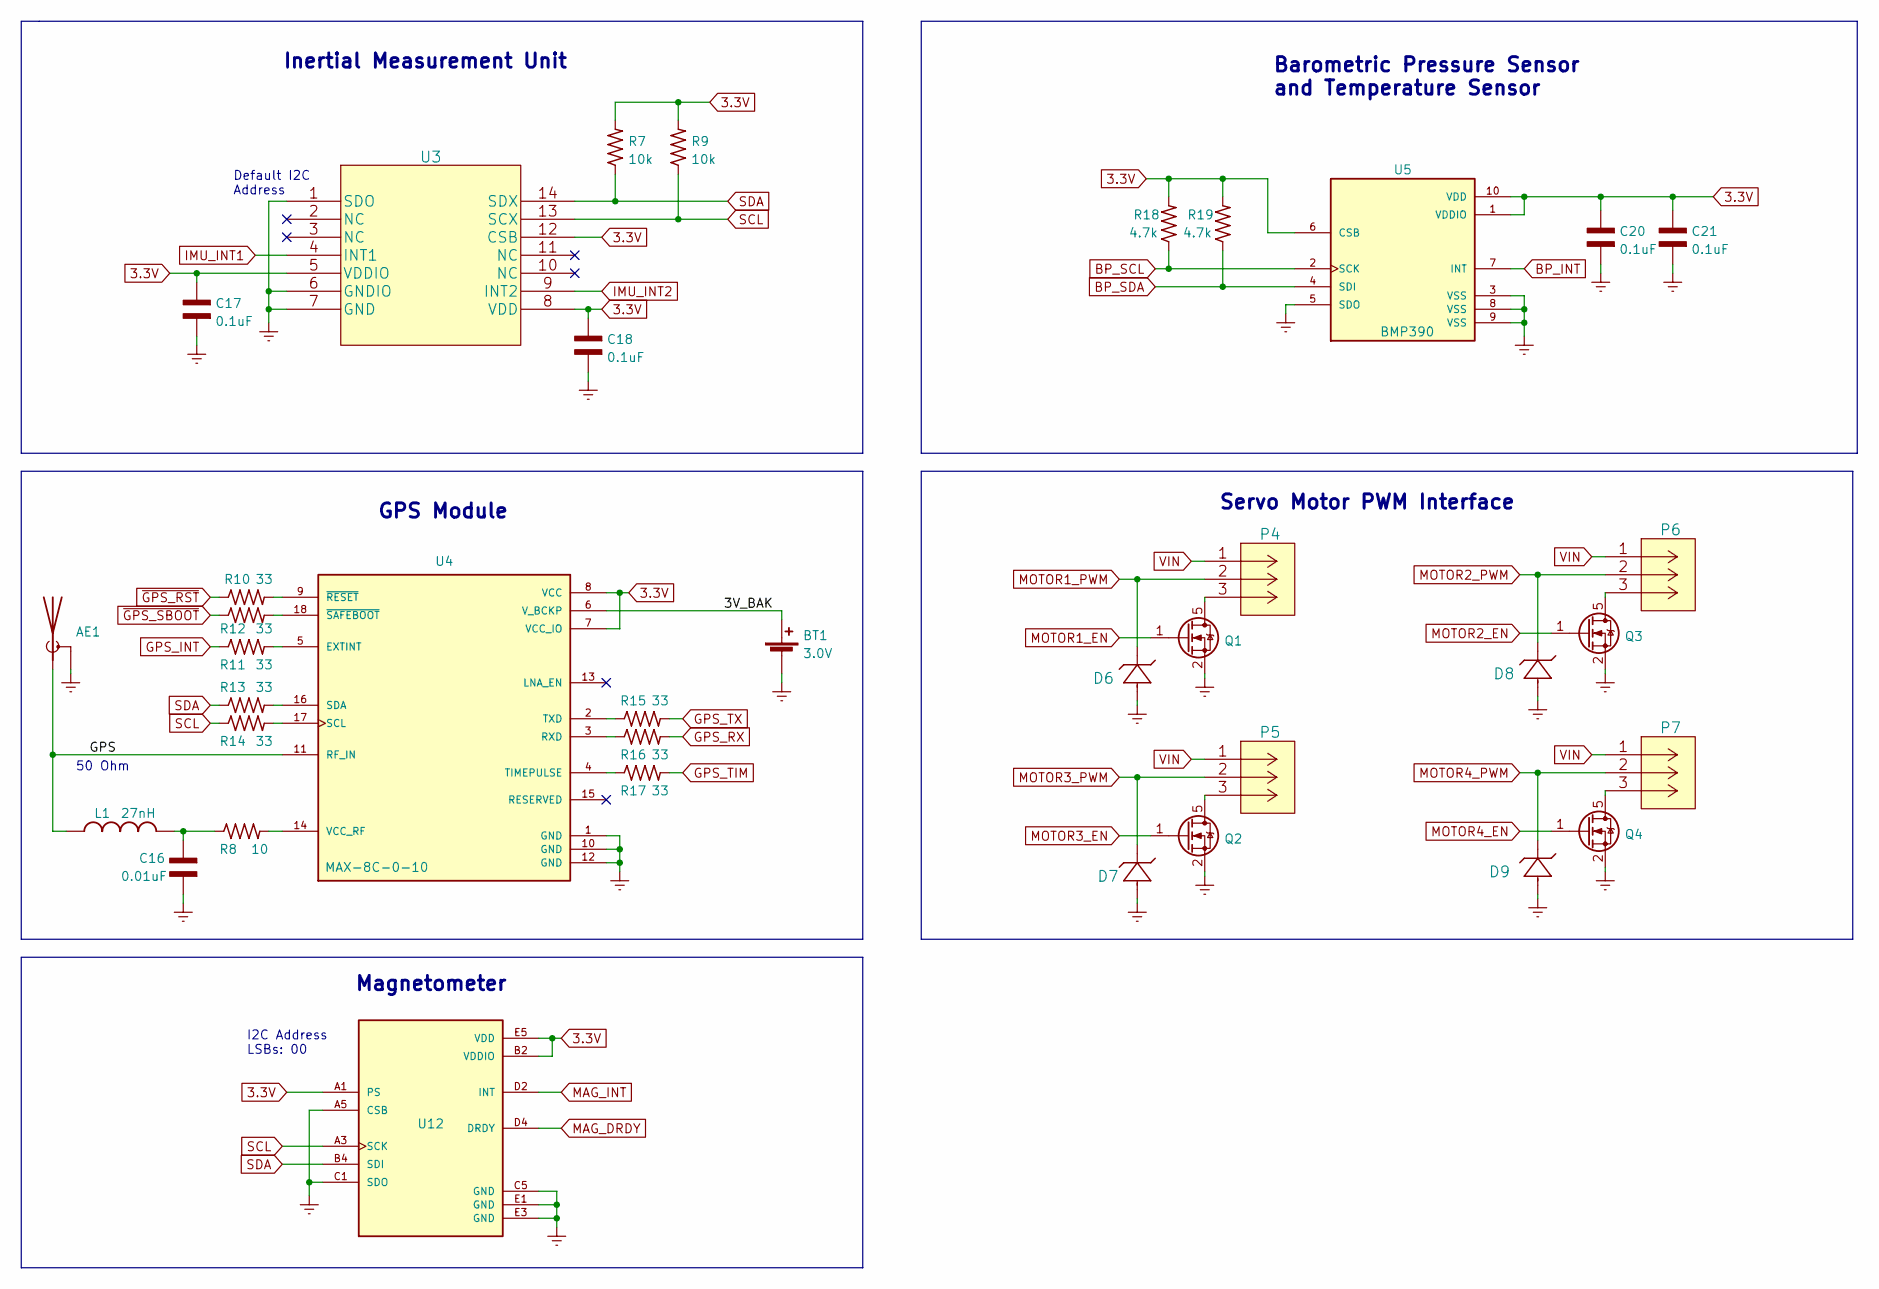
[picture p37: schematic sensors.kicad_sch]

Parts:
AE1: 0734120110; 73412-0110
BT1: MS614SE-FL28E; MS621FE-FL11E; Voltage 3.0V
C16: 0.01uF; CAP_0603
C17, C18, C20, C21: 0.1uF; CAP_0603
D6, D7, D8, D9: MM3Z3V3B
L1: 27nH; L-07C27NJV6T
P4, P5, P6, P7: 440054-3
Q1, Q2, Q3, Q4: QS5U17TR
R7, R9: 10k; RES_0603
R8: 10; RES_0603
R10, R11, R12, R13, R14, R15, R16, R17: 33; RES_0603
R18, R19: 4.7k; RES_0603
U3: BMI323
U4: MAX-8C-0-10; MAX-8C-0
U5: BMP390
U12: BMM150

Connections:
3.3V: C17.1, C18.1, C20.1, C21.1, R7.2, R9.2, R18.2, R19.2, U3.5 (VDDIO), U3.8 (VDD), U3.12 (CSB), U4.7 (VCC_IO), U4.8 (VCC), U5.1 (VDDIO), U5.6 (CSB), U5.10 (VDD), U12.A1 (PS), U12.B2 (VDDIO), U12.E5 (VDD); also elsewhere on the board
/Navigation and Control/3V_BAK: BT1.1 (+), U4.6 (V_BCKP)
/Navigation and Control/GPS: AE1.1 (A), L1.1, U4.11 (RF_IN)
BP_INT: U5.7 (INT); also elsewhere on the board
BP_SCL: R18.1, U5.2 (SCK); also elsewhere on the board
BP_SDA: R19.1, U5.4 (SDI); also elsewhere on the board
Earth: AE1.2 (Shield), BT1.2 (-), C16.2, C17.2, C18.2, C20.2, C21.2, D6.2, D7.2, D8.2, D9.2, Q1.2 (S), Q2.2 (S), Q3.2 (S), Q4.2 (S), U3.1 (SDO), U3.6 (GNDIO), U3.7 (GND), U4.1 (GND), U4.10 (GND), U4.12 (GND), U5.3 (VSS), U5.5 (SDO), U5.8 (VSS), U5.9 (VSS), U12.A5 (CSB), U12.C1 (SDO), U12.C5 (GND), U12.E1 (GND), U12.E3 (GND); also elsewhere on the board
GPS_INT: R12.1; also elsewhere on the board
GPS_RX: R16.2; also elsewhere on the board
GPS_TIM: R17.2; also elsewhere on the board
GPS_TX: R15.2; also elsewhere on the board
IMU_INT1: U3.4 (INT1); also elsewhere on the board
IMU_INT2: U3.9 (INT2); also elsewhere on the board
MAG_DRDY: U12.D4 (DRDY); also elsewhere on the board
MAG_INT: U12.D2 (INT); also elsewhere on the board
MOTOR1_EN: Q1.1 (G); also elsewhere on the board
MOTOR1_PWM: D6.1, P4.2 (GND); also elsewhere on the board
MOTOR2_EN: Q3.1 (G); also elsewhere on the board
MOTOR2_PWM: D8.1, P6.2 (GND); also elsewhere on the board
MOTOR3_EN: Q2.1 (G); also elsewhere on the board
MOTOR3_PWM: D7.1, P5.2 (GND); also elsewhere on the board
MOTOR4_EN: Q4.1 (G); also elsewhere on the board
MOTOR4_PWM: D9.1, P7.2 (GND); also elsewhere on the board
unnamed: C16.1, L1.2, R8.1
unnamed: P4.3, Q1.5 (D)
unnamed: P5.3, Q2.5 (D)
unnamed: P6.3, Q3.5 (D)
unnamed: P7.3, Q4.5 (D)
unnamed: R8.2, U4.14 (VCC_RF)
unnamed: R10.2, U4.9 (~RESET)
unnamed: R11.2, U4.18 (~SAFEBOOT)
unnamed: R12.2, U4.5 (EXTINT)
unnamed: R13.2, U4.16 (SDA)
unnamed: R14.2, U4.17 (SCL)
unnamed: R15.1, U4.2 (TXD)
unnamed: R16.1, U4.3 (RXD)
unnamed: R17.1, U4.4 (TIMEPULSE)
SCL: R9.1, R14.1, U3.13 (SCX), U12.A3 (SCK); also elsewhere on the board
SDA: R7.1, R13.1, U3.14 (SDX), U12.B4 (SDI); also elsewhere on the board
VIN: P4.1 (+12V), P5.1 (+12V), P6.1 (+12V), P7.1 (+12V); also elsewhere on the board
~GPS_RST: R10.1; also elsewhere on the board
~GPS_SBOOT: R11.1; also elsewhere on the board

Notes on the sheet:
I2C Address LSBs: 00
Default I2C Address
Servo Motor PWM Interface
50 Ohm
Magnetometer
GPS Module
Barometric Pressure Sensor and Temperature Sensor
Inertial Measurement Unit

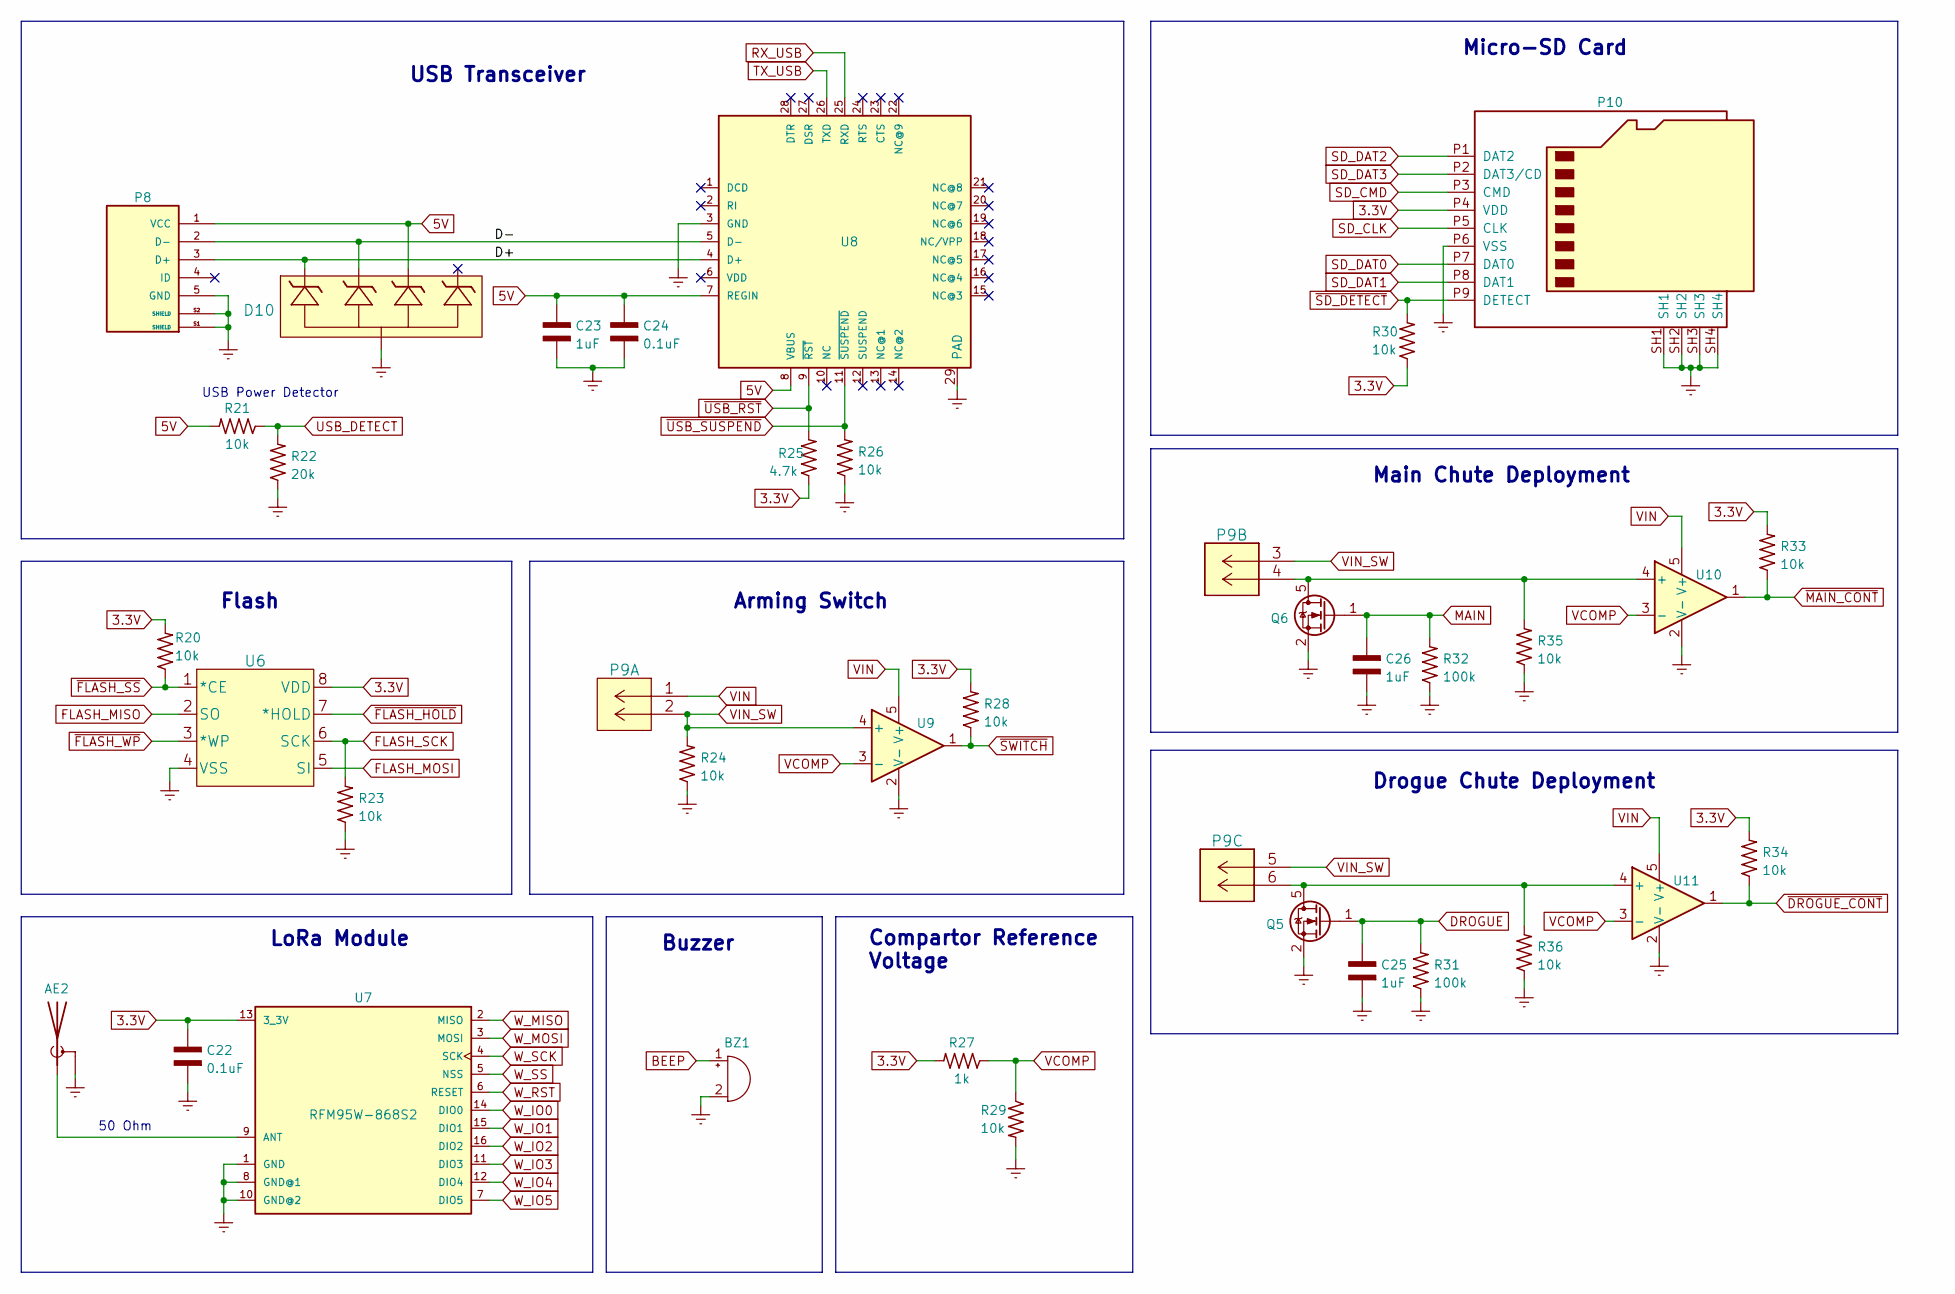
[picture p38: schematic peripherals.kicad_sch]

Parts:
AE2: 142-0701-851
BZ1: AT-1438-TWT-R
C22, C24: 0.1uF; CAP_0603
C23, C25, C26: 1uF; CAP_0603
D10: SP0504BAHTG
P8: USB; 10118194-0001LF
P9: 1984659
P10: Micro_SD_Card; MEM2075-00-140-01-A
Q5, Q6: QS5U17TR
R20, R21, R23, R24, R26, R28, R29, R30, R33, R34, R35, R36: 10k; RES_0603
R22: 20k; RES_0603
R25: 4.7k; RES_0603
R27: 1k; RES_0603
R31, R32: 100k; RES_0603
U6: SST25VF040B-50-4I-S2AE-T
U7: RFM95W-868S2; RFM95
U8: CP2102-GMR(QFN28); CP2012-GMR; MPN CP2102-GMR
U9, U10, U11: TS391IYLT

Connections:
3.3V: C22.1, P10.P4 (VDD), R20.2, R25.1, R27.2, R28.2, R30.1, R33.2, R34.2, U6.8 (VDD), U7.13 (3_3V); also elsewhere on the board
5V: C23.1, C24.1, D10.4, P8.1 (VCC), R21.2, U8.7 (REGIN), U8.8 (VBUS); also elsewhere on the board
/Peripherals/D+: D10.1, P8.3 (D+), U8.4 (D+)
/Peripherals/D-: D10.3, P8.2 (D-), U8.5 (D-)
BEEP: BZ1.1 (-); also elsewhere on the board
DROGUE: C25.1, Q5.1 (G), R31.2; also elsewhere on the board
Earth: AE2.2 (Shield), BZ1.2 (+), C22.2, C23.2, C24.2, C25.2, C26.2, D10.2, P8.5 (GND), P8.S1 (SHIELD), P8.S2 (SHIELD), P10.P6 (VSS), P10.SH1, P10.SH2, P10.SH3, P10.SH4, Q5.2 (S), Q6.2 (S), R22.1, R23.1, R24.1, R26.1, R29.2, R31.1, R32.1, R35.1, R36.1, U6.4 (VSS), U7.1 (GND), U7.8 (GND@1), U7.10 (GND@2), U8.3 (GND), U8.29 (PAD), U9.2 (V-), U10.2 (V-), U11.2 (V-); also elsewhere on the board
FLASH_MISO: U6.2 (SO); also elsewhere on the board
FLASH_MOSI: U6.5 (SI); also elsewhere on the board
FLASH_SCK: R23.2, U6.6 (SCK); also elsewhere on the board
MAIN: C26.1, Q6.1 (G), R32.2; also elsewhere on the board
unnamed: AE2.1 (A), U7.9 (ANT)
unnamed: P9.4 (6), Q6.5 (D), R35.2, U10.4 (+)
unnamed: P9.6, Q5.5 (D), R36.2, U11.4 (+)
RX_USB: U8.25 (RXD); also elsewhere on the board
SD_CLK: P10.P5 (CLK); also elsewhere on the board
SD_CMD: P10.P3 (CMD); also elsewhere on the board
SD_DAT0: P10.P7 (DAT0); also elsewhere on the board
SD_DAT1: P10.P8 (DAT1); also elsewhere on the board
SD_DAT2: P10.P1 (DAT2); also elsewhere on the board
SD_DAT3: P10.P2 (DAT3/CD); also elsewhere on the board
TX_USB: U8.26 (TXD); also elsewhere on the board
USB_DETECT: R21.1, R22.2; also elsewhere on the board
VCOMP: R27.1, R29.1, U9.3 (-), U10.3 (-), U11.3 (-)
VIN: P9.1 (5), U9.5 (V+), U10.5 (V+), U11.5 (V+); also elsewhere on the board
VIN_SW: P9.2 (6), P9.3 (5), P9.5, R24.2, U9.4 (+)
W_IO0: U7.14 (DIO0); also elsewhere on the board
W_IO1: U7.15 (DIO1); also elsewhere on the board
W_IO2: U7.16 (DIO2); also elsewhere on the board
W_IO3: U7.11 (DIO3); also elsewhere on the board
W_IO4: U7.12 (DIO4); also elsewhere on the board
W_IO5: U7.7 (DIO5); also elsewhere on the board
W_MISO: U7.2 (MISO); also elsewhere on the board
W_MOSI: U7.3 (MOSI); also elsewhere on the board
W_RST: U7.6 (RESET); also elsewhere on the board
W_SCK: U7.4 (SCK); also elsewhere on the board
W_SS: U7.5 (NSS); also elsewhere on the board
~DROGUE_CONT: R34.1, U11.1; also elsewhere on the board
~FLASH_HOLD: U6.7 (*HOLD); also elsewhere on the board
~FLASH_SS: R20.1, U6.1 (*CE); also elsewhere on the board
~FLASH_WP: U6.3 (*WP); also elsewhere on the board
~MAIN_CONT: R33.1, U10.1; also elsewhere on the board
~SD_DETECT: P10.P9 (DETECT), R30.2; also elsewhere on the board
~SWITCH: R28.1, U9.1; also elsewhere on the board
~USB_RST: R25.2, U8.9 (~RST); also elsewhere on the board
~USB_SUSPEND: R26.2, U8.11 (~SUSPEND); also elsewhere on the board

Notes on the sheet:
Micro-SD Card
Compartor Reference Voltage
USB Power Detector
Arming Switch
50 Ohm
Drogue Chute Deployment
Buzzer
Flash
USB Transceiver
Main Chute Deployment
LoRa Module

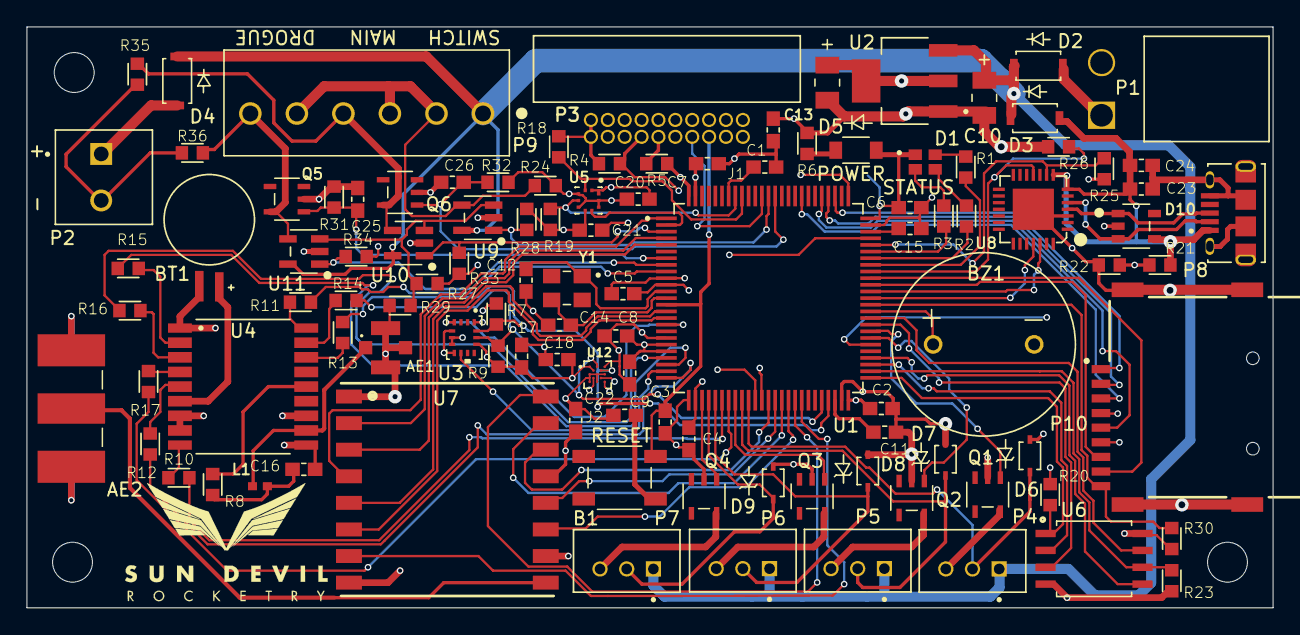
[picture p39: board Flight-Computer.kicad_pcb from above]

Board: 4 copper layers, 93.7 x 43.7 mm, 113 parts (1 on the bottom side), 104 nets.
