SunDevilRocketry/Flight-Computer/(commit log)

2021-07-14 Copied PCB file structure
2021-07-14 Started lib files
    [Avionics-Flight-Computer.kicad_pcb, Avionics-Flight-Computer.sch, stm32h750vbt6.stp]
2021-07-20 Added caps and resistors to lib files
    [CAP_CL10_SAM.step, RC0805FR-071K54L.STEP, RES_MCT_0603_VIS.step]
2021-07-20 Added programming connector to lib files
    [SBH11-PBPC-D05-RA-BK.stp]
2021-07-20 added linear regulator parts to lib files
    [CWR11HH106KB.step, LMS8117AMP-3.3_NOPB.step]
2021-09-23 Copied files from L0002 directory
    [Avionics-Flight-Computer.kicad_pcb, Avionics-Flight-Computer.sch, Connectors.sch, Flash_SD.sch, Flight-Computer.kicad_pcb, Flight-Computer.sch, Programmer.sch, USB.sch]
2022-05-22 added 3D files to base lib files
    [CAP_0603.step, CWR11HH106KB.step, PTS647SM38SMTR2LFS.step, RES_0603.step, RES_0805.step, SST25VF040B-50-4I-S2AE-T.step, TPS2115APWR.step]
2022-05-22 added green LED to lib files
    [SML-LX1206GC-TR.step]
2022-05-22 added tantalum capacitor to lib files
    [T491A106K010AT.step]
2022-05-22 added power mosfet to lib files
    [QS5U17TR.step]
2022-05-22 added programmer connector to lib files
    [3220-20-0200-00.stp]
2022-05-22 added ESD chip to lib files
    [SP0504BAHTG.step]
2022-05-22 added screw terminals for ematches
    [282837-6.STEP]
2022-05-22 added rgb LED to lib files
    [CLMVC-FKA-CL1D1L71BB7C3C3.STEP]
2022-05-22 added crystal to lib files
    [ECS-240-18-33-JGN-TR.STEP]
2022-05-22 added power screw terminal to lib files
    [282837-2.step]
2022-05-22 cleaned up mcu schematic
    [Connectors.kicad_sch, Flash_SD.kicad_sch, Flight-Computer.kicad_sch, USB.kicad_sch, power.kicad_sch]
2022-05-22 added logo and mounting holes to lib files
2022-05-22 implemented rgb led in schematic
    [Flight-Computer.kicad_sch]
2022-05-22 added logo and mounting holes to schematic
    [Flight-Computer.kicad_sch]
2022-05-22 implemented crystal oscillator in schematic
    [Connectors.kicad_sch, Flash_SD.kicad_sch, Flight-Computer.kicad_sch, USB.kicad_sch, power.kicad_sch]
2022-05-22 implemented mcu decoupling and regulator caps in schematic
    [Flight-Computer.kicad_sch]
2022-05-22 deleted connector schematic sheet
    [Flight-Computer.kicad_sch]
2022-05-22 added second sheet for peripheral functionality
    [Flight-Computer.kicad_sch, peripherals.kicad_sch]
2022-05-22 added main power connector to lib files
    [647676-2.step]
2022-05-22 added schottky diode to lib files
    [SM5819PL-TP.step]
2022-05-22 implemented 3.3V regulator in schematic
    [Flight-Computer.kicad_sch]
2022-05-22 plotted schematic to pdf
2022-05-22 added uart to usb bridge to lib files
    [CP2102-GMR_QFN28.step, Flight-Computer.kicad_sch]
2022-05-22 added usb connector to lib files
    [10118194-0001LF.step]
2022-05-22 implemented usb transceiver in schematic
    [Flight-Computer.kicad_sch, peripherals.kicad_sch]
2022-05-22 updated schematic pdf with usb transceiver
2022-05-23 implemented flash in schematic
    [Flight-Computer.kicad_sch, peripherals.kicad_sch]
2022-05-23 added comparator to lib files
    [Flight-Computer.kicad_sch, TS391lYLT.step, peripherals.kicad_sch]
2022-05-23 implemented parachute deployment circuitry in schematic
    [Flight-Computer.kicad_sch]
2022-05-23 added usb data traces to mcu in schematic
    [Flight-Computer.kicad_sch]
2022-05-23 added IMU to lib files
    [MPU-9250.step, peripherals.kicad_sch]
2022-05-23 added buzzer to lib files
    [AI-1223-TWT-12V-3-R.step]
2022-05-28 added sensors sheet
    [Flight-Computer.kicad_sch, sensors.kicad_sch]
2022-05-28 implemented IMU in schematic
    [Flight-Computer.kicad_sch, sensors.kicad_sch]
2022-05-28 adjusted imu resistor labels
    [sensors.kicad_sch]
2022-05-28 added imu i2c signals to mcu in schematic
    [Flight-Computer.kicad_sch]
2022-05-28 added parachute deployment label to peripherals sheet
    [Flight-Computer.kicad_sch]
2022-05-28 added gps module to lib files
    [MAX-8C-0-10.step]
2022-05-28 added more labels to subsheets
    [Flight-Computer.kicad_sch]
2022-05-28 added LoRa module to lib files
    [Flight-Computer.kicad_sch, RFM95.step, sensors.kicad_sch]
2022-05-28 added pressure sensor to lib files
2022-05-29 added gps antenna jack to lib files
    [73412-0110.step]
2022-05-29 added backup battery to lib files
    [Flight-Computer.kicad_sch, MS621FE-1.STEP, sensors.kicad_sch]
2022-05-29 implemented gps module for passive antenna design
    [Flight-Computer.kicad_sch, sensors.kicad_sch]
2022-05-30 implemented buzzer in schematic
    [AI-1223-TWT-12V-3-R.step, AT-1438-TWT-R.step, Flight-Computer.kicad_sch, peripherals.kicad_sch]
2022-05-30 added RF SMA connector to lib files
    [142-0701-801.STEP, Flight-Computer.kicad_sch, peripherals.kicad_sch]
2022-05-30 implemented lora module in schematic
    [Flight-Computer.kicad_sch, peripherals.kicad_sch]
2022-05-30 added decoupling capacitor to lora module
    [Flight-Computer.kicad_sch, peripherals.kicad_sch]
2022-05-30 implemented barometric pressure sensor in schematic
    [Flight-Computer.kicad_sch, sensors.kicad_sch]
2022-05-30 changed name of main schematic sheet
    [Flight-Computer.kicad_sch]
2022-05-30 minor schematic formatting changes
    [Flight-Computer.kicad_sch, peripherals.kicad_sch]
2022-05-30 added motor connectors to lib files
    [440054-3.step]
2022-06-01 added zener diode to lib files
    [Flight-Computer.kicad_sch, MM3Z3V3B.step, sensors.kicad_sch]
2022-06-01 implemented pwm motor interface in schematic
    [Flight-Computer.kicad_sch, sensors.kicad_sch]
2022-06-01 added inductor to lib files
    [Flight-Computer.kicad_sch, L-07C27NJV6T.step]
2022-06-01 added power supply for active gps antenna
    [Flight-Computer.kicad_sch, sensors.kicad_sch]
2022-06-03 added 3d model for BMP390
    [BMP390.STEP]
2022-06-03 added mcu signals for peripherals
    [Flight-Computer.kicad_sch, peripherals.kicad_sch, sensors.kicad_sch]
2022-06-03 setup layout design rules
    [Flight-Computer.kicad_pcb, Flight-Computer.kicad_sch, peripherals.kicad_sch, sensors.kicad_sch]
2022-06-04 placed pcb parts on board and defined form factor
    [Flight-Computer.kicad_pcb, Flight-Computer.kicad_sch, MEM2075-00-140-01-A.stp, peripherals.kicad_sch]
2022-06-05 routed main peripheral functionality excluding parachute deployment circuitry
    [AT-1438-TWT-R.STEP, AT-1438-TWT-R.step, Flight-Computer.kicad_pcb, Flight-Computer.kicad_sch]
2022-06-06 finished routing
    [440129-3.stp, Flight-Computer.kicad_pcb, Flight-Computer.kicad_sch]
2022-06-06 finished resolving DRC errors
    [Flight-Computer.kicad_pcb]
2022-09-16 generated gerbers
    [Flight-Computer-B_Cu.gbr, Flight-Computer-B_Mask.gbr, Flight-Computer-B_Paste.gbr, Flight-Computer-B_Silkscreen.gbr, Flight-Computer-Edge_Cuts.gbr, Flight-Computer-F_Cu.gbr, Flight-Computer-F_Mask.gbr, Flight-Computer-F_Paste.gbr]
2022-12-14 added usb detector to schemtaic
    [Flight-Computer.kicad_sch, peripherals.kicad_sch, sensors.kicad_sch]
2022-12-14 added IMU and magnetometer to lib files
    [BMI323.step, BMM150.step]
2022-12-14 implemented new imu in schematic
    [Flight-Computer.kicad_sch, sensors.kicad_sch]
2022-12-15 implemented magnetometer in schematic
    [Flight-Computer.kicad_sch, sensors.kicad_sch]
2022-12-15 replaced screw terminals with smaller parts
    [1546551-2.step, 1984659.stp, Flight-Computer.kicad_sch, peripherals.kicad_sch]
2022-12-15 fixed incorrect LoRa MISO and MOSI connections
    [peripherals.kicad_sch]
2022-12-15 matched footprints to symbols
    [Flight-Computer.kicad_sch, peripherals.kicad_sch, sensors.kicad_sch]
2022-12-15 started rev 2 routing
    [Flight-Computer.kicad_pcb, Flight-Computer.kicad_sch, sensors.kicad_sch]
2022-12-15 continued rev 2 routing
    [Flight-Computer.kicad_pcb]
2022-12-16 continued rev2 routing
    [Flight-Computer.kicad_pcb, Flight-Computer.kicad_sch, sensors.kicad_sch]
2022-12-16 finished rev 2 routing
    [Flight-Computer.kicad_pcb, Flight-Computer.kicad_sch]
2022-12-16 resolved rev2 DRC errors
    [Flight-Computer.kicad_pcb]
2022-12-16 generated fabrication outputs
    [Flight-Computer-B_Cu.gbr, Flight-Computer-B_Mask.gbr, Flight-Computer-B_Paste.gbr, Flight-Computer-B_Silkscreen.gbr, Flight-Computer-Edge_Cuts.gbr, Flight-Computer-F_Cu.gbr, Flight-Computer-F_Mask.gbr, Flight-Computer-F_Paste.gbr]
2022-12-16 moved POWER label away from board edge
    [Flight-Computer-B_Cu.gbr, Flight-Computer-B_Mask.gbr, Flight-Computer-B_Paste.gbr, Flight-Computer-B_Silkscreen.gbr, Flight-Computer-Edge_Cuts.gbr, Flight-Computer-F_Cu.gbr, Flight-Computer-F_Mask.gbr, Flight-Computer-F_Paste.gbr]
2022-12-16 updated readme to rev 2
    [Flight-Computer.kicad_pcb]
2022-12-16 generated Rev2 cad model
2022-12-17 plotted rev2 schematic to pdf
2022-12-20 added ignition continuity pull down resistors
    [Flight-Computer.kicad_sch, peripherals.kicad_sch, sensors.kicad_sch]
2023-01-07 added ignition comparator pull down resistors
    [Flight-Computer-B_Cu.gbr, Flight-Computer-B_Mask.gbr, Flight-Computer-B_Paste.gbr, Flight-Computer-B_Silkscreen.gbr, Flight-Computer-Edge_Cuts.gbr, Flight-Computer-F_Cu.gbr, Flight-Computer-F_Mask.gbr, Flight-Computer-F_Paste.gbr]
