SunDevilRocketry/Flight-Computer/(notices)

Notices in the files:
CAD/3Dfiles/MEM2075-00-140-01-A.stp:
FILE_NAME( 'p:/temp/worker_30/temp/exporttempdir_5296_761_qBBEl/format_0/MEM2075-00-140-01-A.stp', '2021-07-01T16:51:58', ( 'License CC BY-ND 4.0' ), ( 'CADENAS' ), ' ', 'PARTsolutions', ' ' );
parts and their libraries:
Copyright 2021 Accelerated Designs. All rights reserved.
